oklinov/alu/README.md

View this project on [CADLAB.io](https://cadlab.io/project//TODO). 

# Template for PB170 projects at FI MU Brno
Add your user guide here.

## Photos

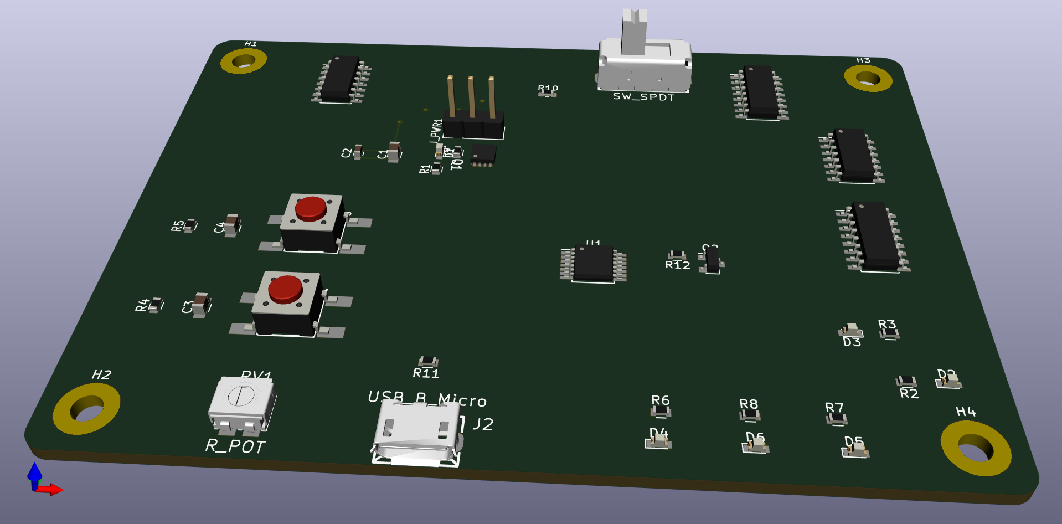
[picture p1: preview/3D.png]
Sample PCB image (unrouted)


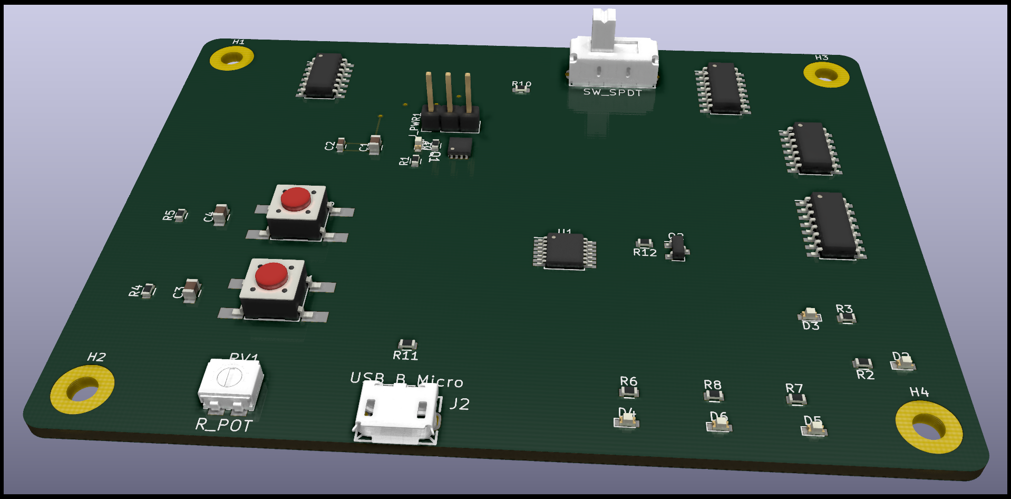
[picture p2: preview/raytracing.png]
Sample PCB image using ray tracing (unrouted)
