oklinov/alu/doc/doc.pdf

# PB170 – ALU

Ondrej Klinovský, Jakub Maloštík

20. februára 2021

Ciel’om tohto projektu bolo vytvorit’ aritmeticko-logickú jednotku (ALU) so štyrmi operáciami. ALU pracuje so 4-bitovými číslami v doplnkovom kóde. Zvo-lili sme dve aritmetické operácie (sčítanie a odčítanie) a dve logické (logický súčin a súčet).

ALU sa ovláda pomocou dvoch tlačítiek a ôsmych prepínačov. Prepínače predstavujú vstup pre dve 4-bitové čísla. Operáciu nad tymíto číslami je možné zvolit’ s dvomi tlačítkami následovne:

X | Y | operácia
0 0 1 1 | 0 1 0 1 | sčítanie odčítanie logický súčin logický súčet

Výstup ALU pozostáva zo štyroch LED-diód predstavujúcich výsledok zvolenej operácie a troch LED-diód predstavujúcich príznaky operácie: nulový výsledok, záporný výsledok a pretečenie aritmetickej operácie.

Celý obvod sme si rozdelili na tri časti: vstup, výstup a samotná ALU. Výstup je najjednoduchšia čast’, tvorí ho sedem LED-diód reprezentujúcich 4-bitový výsledok a tri príznaky. Výstup je o niečo zložitejší. Nachádzajú sa tu dve tlačítka napojené na D klopné obvody, vd’aka ktorým sme schopní menit’ operáciu ALU. Osem prepínačov slúži pre zadávanie dvoch 4-bitových čísel pre ALU. Na každý vstup je napojená jedna LED-dióda pre zobrazenie dát, s ktorými ALU pracuje.

Tret’ou, najkomplikovanejšou čast’ou je ALU, ktorá sa pozostáva z aritmetickej (sčítačky) a logickej časti, multiplexeru a logiky pre zobrazenie príznakov. Mut-liplexer na základe významnejšieho bitu operácie rozhoduje, či na vstup pošle výsledok aritmetickej alebo logickej časti. Obe majú na vstupe dve 4-bitové čísla a operačný bit (menej významný bit operácie) a na výstupe 4-bitový výsledok. V logickej časti sa nachádzajú štyri AND brány a štyri OR brány smerujúce do multiplexeru, ktorý na základe operačného bitu rozhodne, ktorý výsledok pošle na výstup. V aritmetickej časti nie je multiplexer potrebný. Odčítanie je možné

1


Obr. 1: Prvotný návrh sme spravili v simulátore digitalnych obvodov Digital. Na obázku je vidiet’ celá shéma obvodu ALU. Pre zjednodušenie návrhu sme použili vstavané komponenty ako sčítačky alebo multiplexer. Vstupy su riešené jednoduchými prepínačmi.

previest’ inverziou bitov čísla B a pripočítanie jednotky k výsledku. Inverzia bitov je implementovaná pomocou XOR brány. Zatial’ čo číslo A na napojené priamo na sčítačku, číslo B prechádza cez XOR brány, kde tvorí vstup spolu s operačným bitom. Ak je operačný bit 0 (sčítanie), číslo B prejde XORmi bez zmeny. V prípade odčítania (operačný bit má hodnotu 1) XOR invertuje všetky bity čísla B. Pripočítanie jednotky je docielené tým, že operačný bit je napojený na carry-in vstup sčítačky. V prípade sčitovania bude mat’ carry-in hodnotu
0. Okrem 4-bitového čísla ma sčítačka na výstupe bit signalizujúci pretečenie, ktorý je výsledkom XOR operácie dvoch najvýznamnejších bitov výsledného čísla.

2

# LED red+5V GND R⁴³ 220R

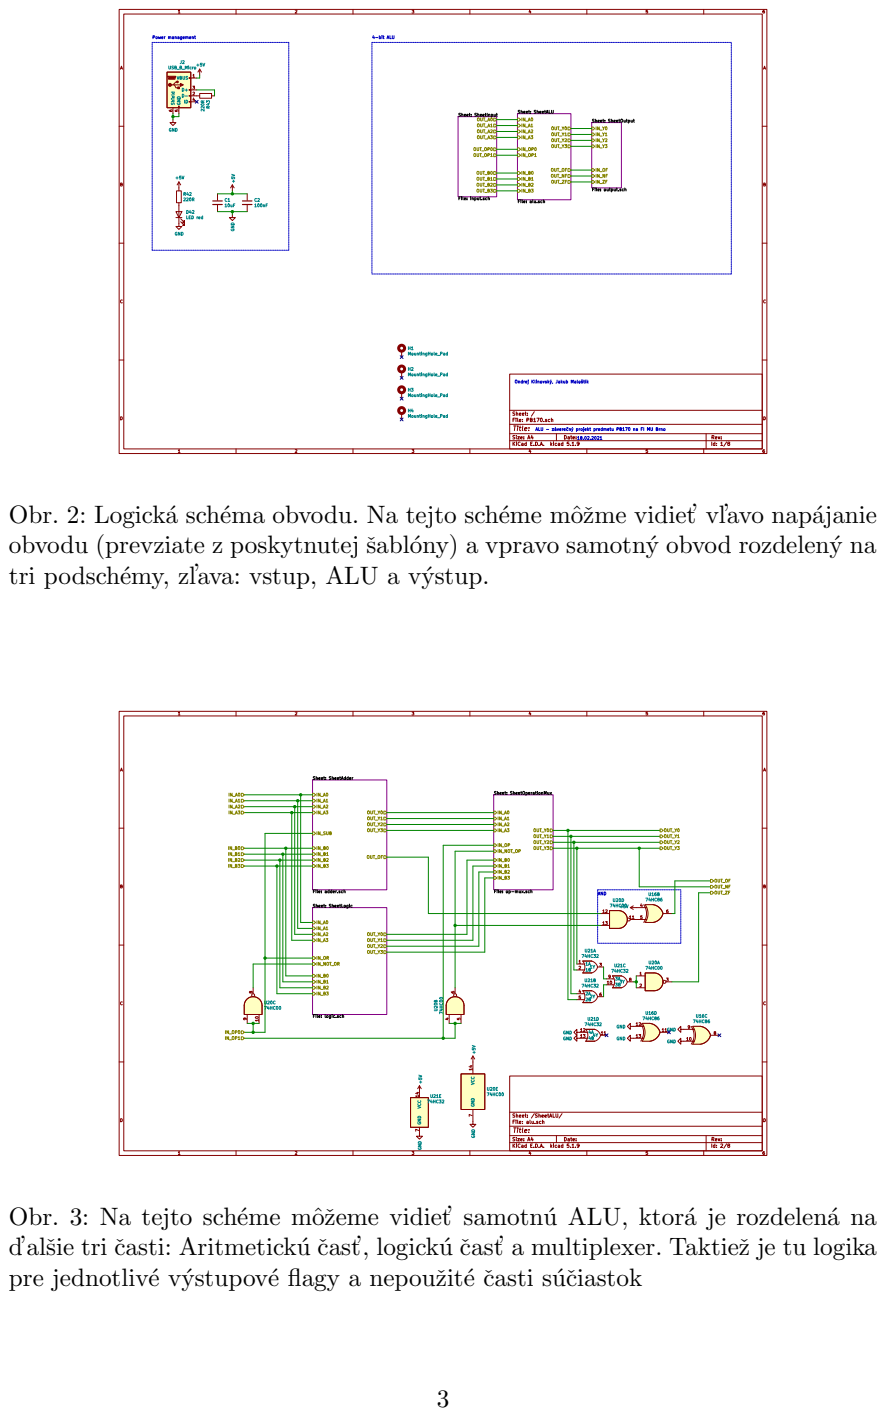
[picture p5: page 3]

Id: 1/8 Title: File: PB170.sch Sheet: / Sheet: SheetInput

Ondrej Klinovský, Jakub Malotík

18.02.2021 ALU - záverený projekt predmetu PB170 na FI MU Brno

Obr. 2: Logická schéma obvodu. Na tejto schéme môžme vidiet’ vl’avo napájanie
obvodu (prevziate z poskytnutej šablóny) a vpravo samotný obvod rozdelený na

Sheet: SheetAdder File: adder.sch

Id: 2/8 Title: File: alu.sch Sheet: /SheetALU/ Sheet: SheetOperationMux

File: op-mux.sch

Obr. 3: Na tejto schéme môžeme vidiet’ samotnú ALU, ktorá je rozdelená na
d’alšie tri časti: Aritmetickú čast’, logickú čast’ a multiplexer. Taktiež je tu logika
pre jednotlivé výstupové flagy a nepoužité časti súčiastok

# 74HC74 D8

## 3 SW2 SW_SPDT D10

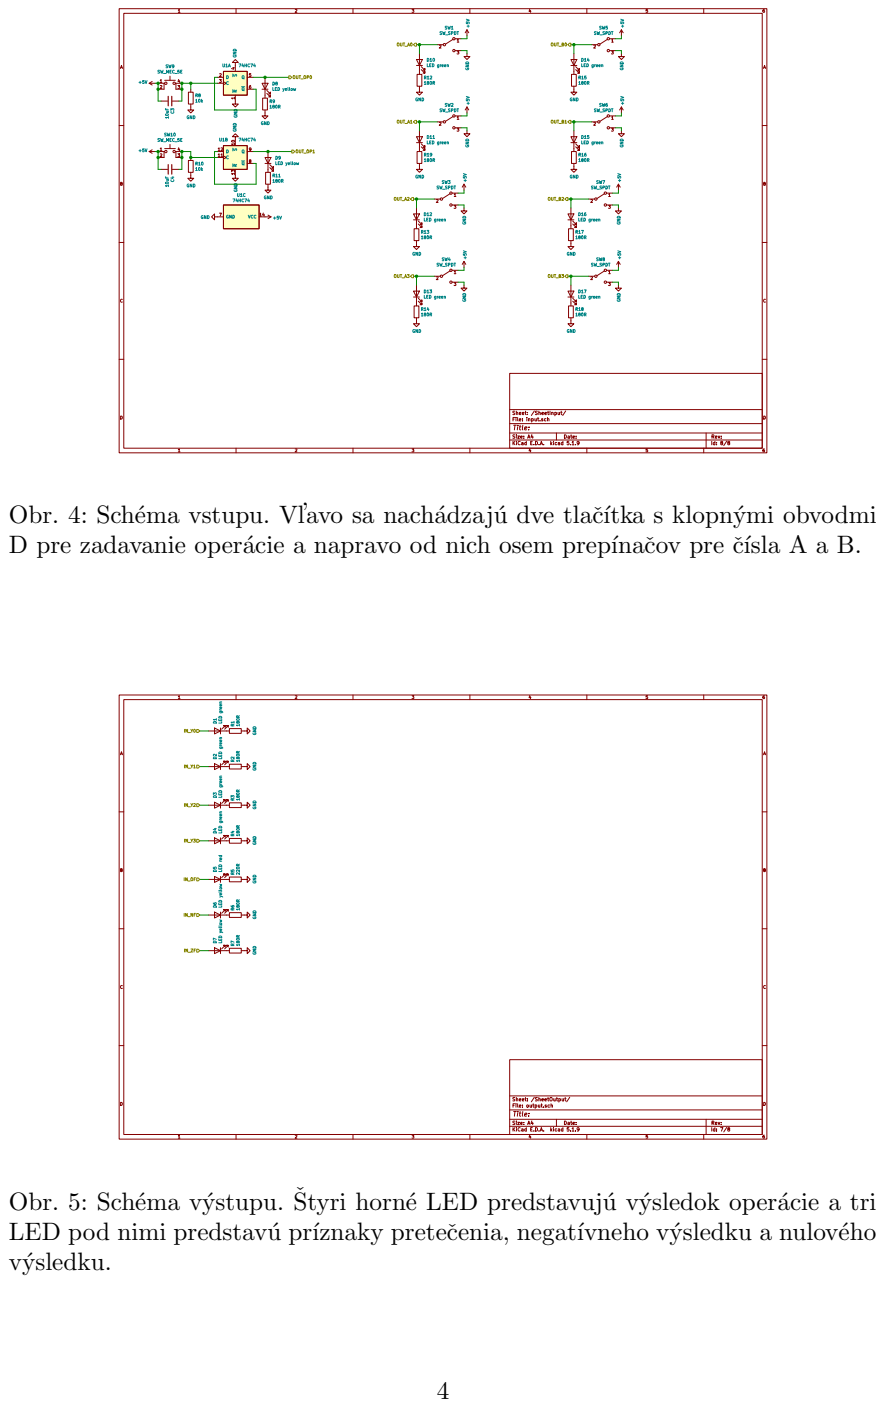
[picture p6: page 4]

Obr. 4: Schéma vstupu. Vl’avo sa nachádzajú dve tlačítka s klopnými obvodmi

Obr. 5: Schéma výstupu. Styri horné LED predstavujú výsledok operácie a tri ˇ
LED pod nimi predstavú príznaky pretečenia, negatívneho výsledku a nulového
výsledku.

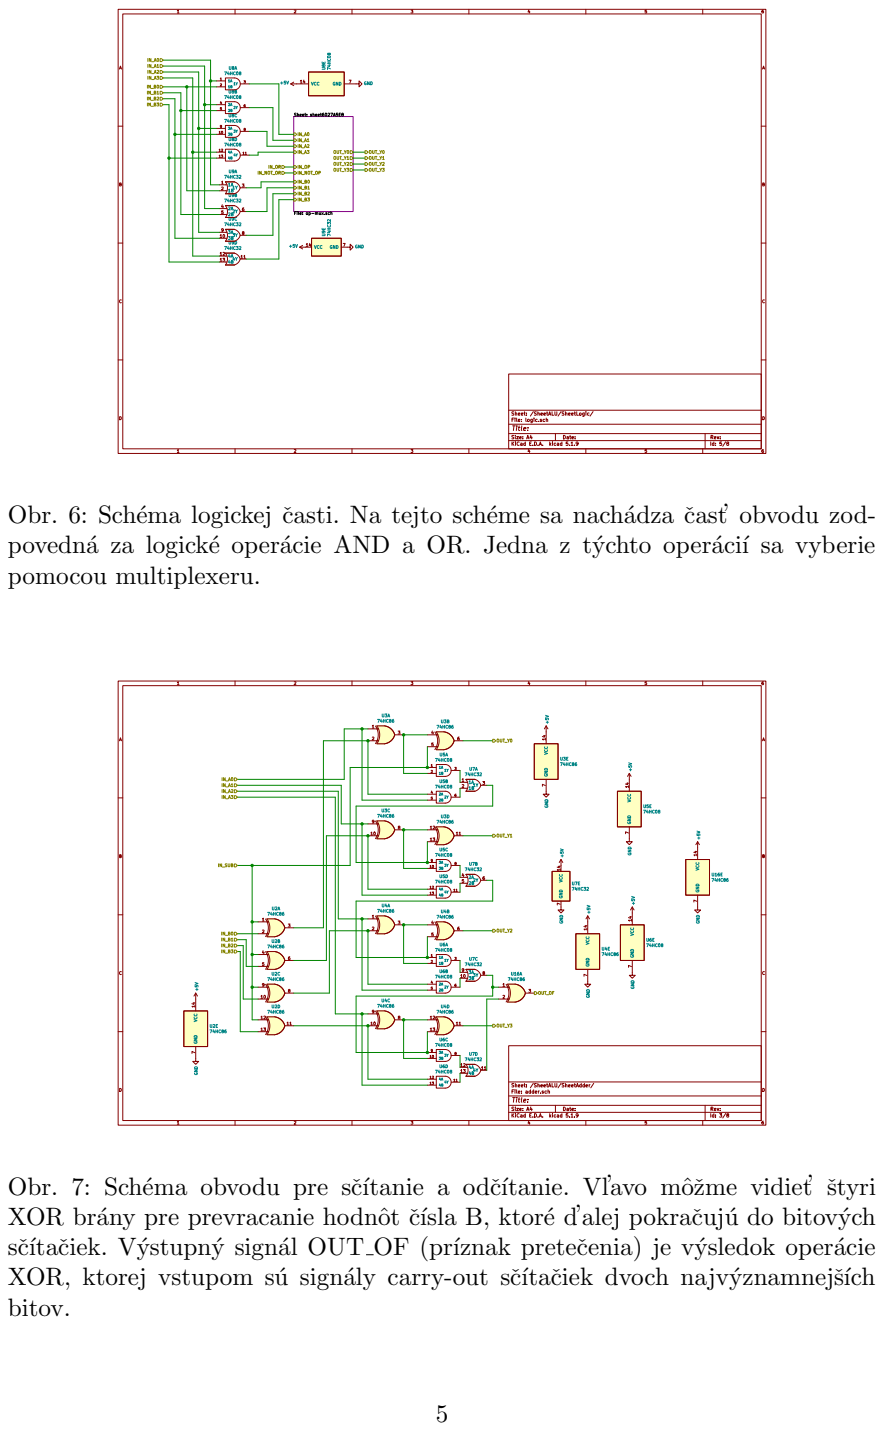
[picture p7: page 5]

Sheet: /SheetALU/SheetLogic/ Sheet: sheet6027A5E8 File: op-mux.sch

Obr. 6: Schéma logickej časti. Na tejto schéme sa nachádza čast’ obvodu zod-
povedná za logické operácie AND a OR. Jedna z týchto operácií sa vyberie

Obr. 7: Schéma obvodu pre sčítanie a odčítanie. Vl’avo môžme vidiet’ štyri
XOR brány pre prevracanie hodnôt čísla B, ktoré d’alej pokračujú do bitových
sčítačiek. Výstupný signál OUT OF (príznak pretečenia) je výsledok operácie
XOR, ktorej vstupom sú signály carry-out sčítačiek dvoch najvýznamnejších
bitov.

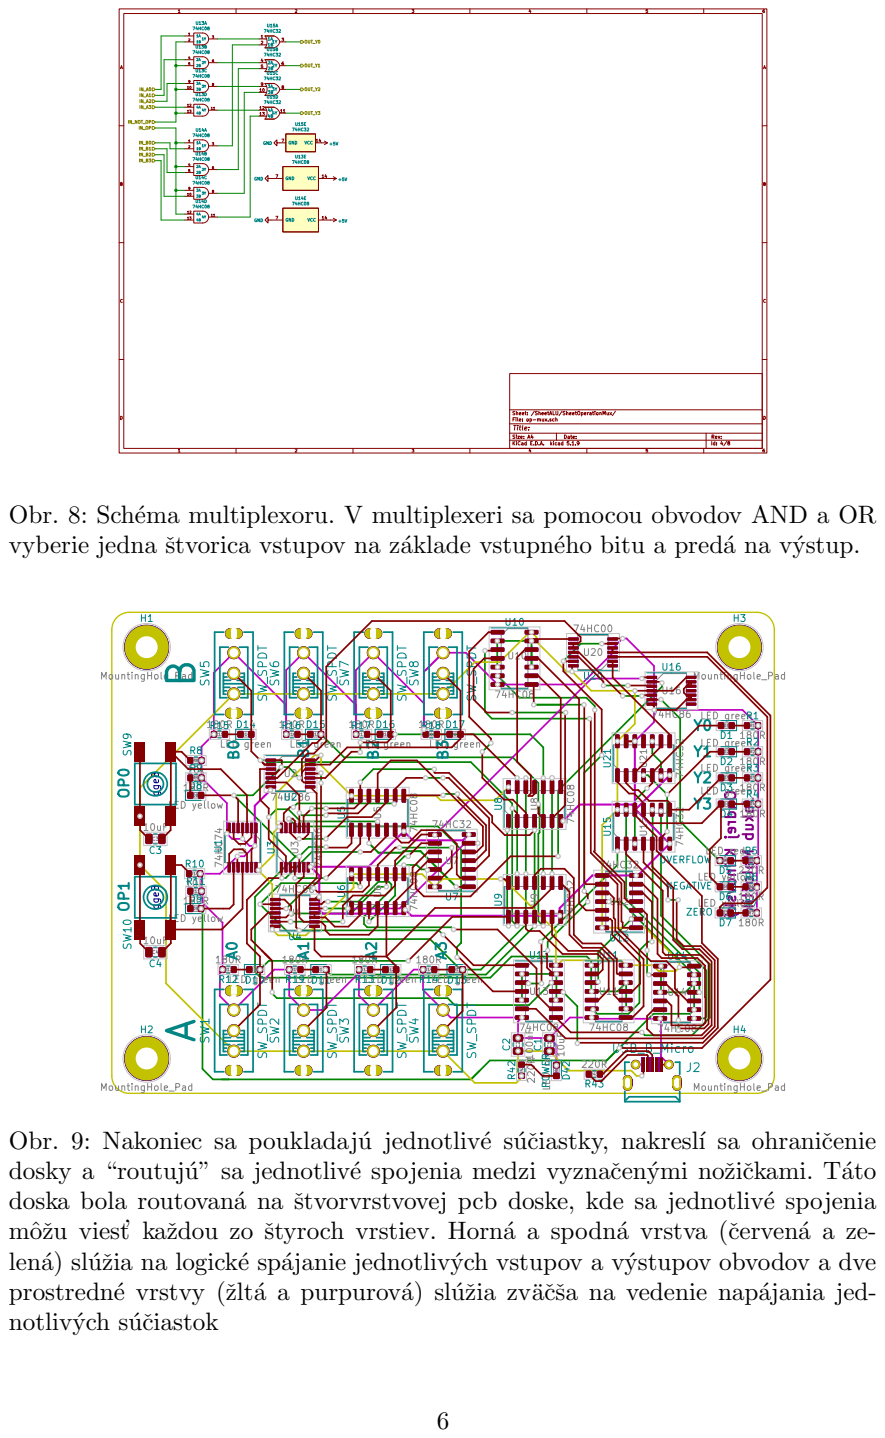
[picture p8: page 6]

Sheet: /SheetALU/SheetOperationMux/ GND

File: op-mux.sch
Id: 4/8 Title:

Obr. 8: Schéma multiplexoru. V multiplexeri sa pomocou obvodov AND a OR
vyberie jedna štvorica vstupov na základe vstupného bitu a predá na výstup.

Obr. 9: Nakoniec sa poukladajú jednotlivé súčiastky, nakreslí sa ohraničenie
dosky a “routujú” sa jednotlivé spojenia medzi vyznačenými nožičkami. Táto
doska bola routovaná na štvorvrstvovej pcb doske, kde sa jednotlivé spojenia
môžu viest’ každou zo štyroch vrstiev. Horná a spodná vrstva (červená a ze-
lená) slúžia na logické spájanie jednotlivých vstupov a výstupov obvodov a dve
prostredné vrstvy (žltá a purpurová) slúžia zväčša na vedenie napájania jed-
notlivých súčiastok
