oklinov/alu/doc/img/pcb.pdf

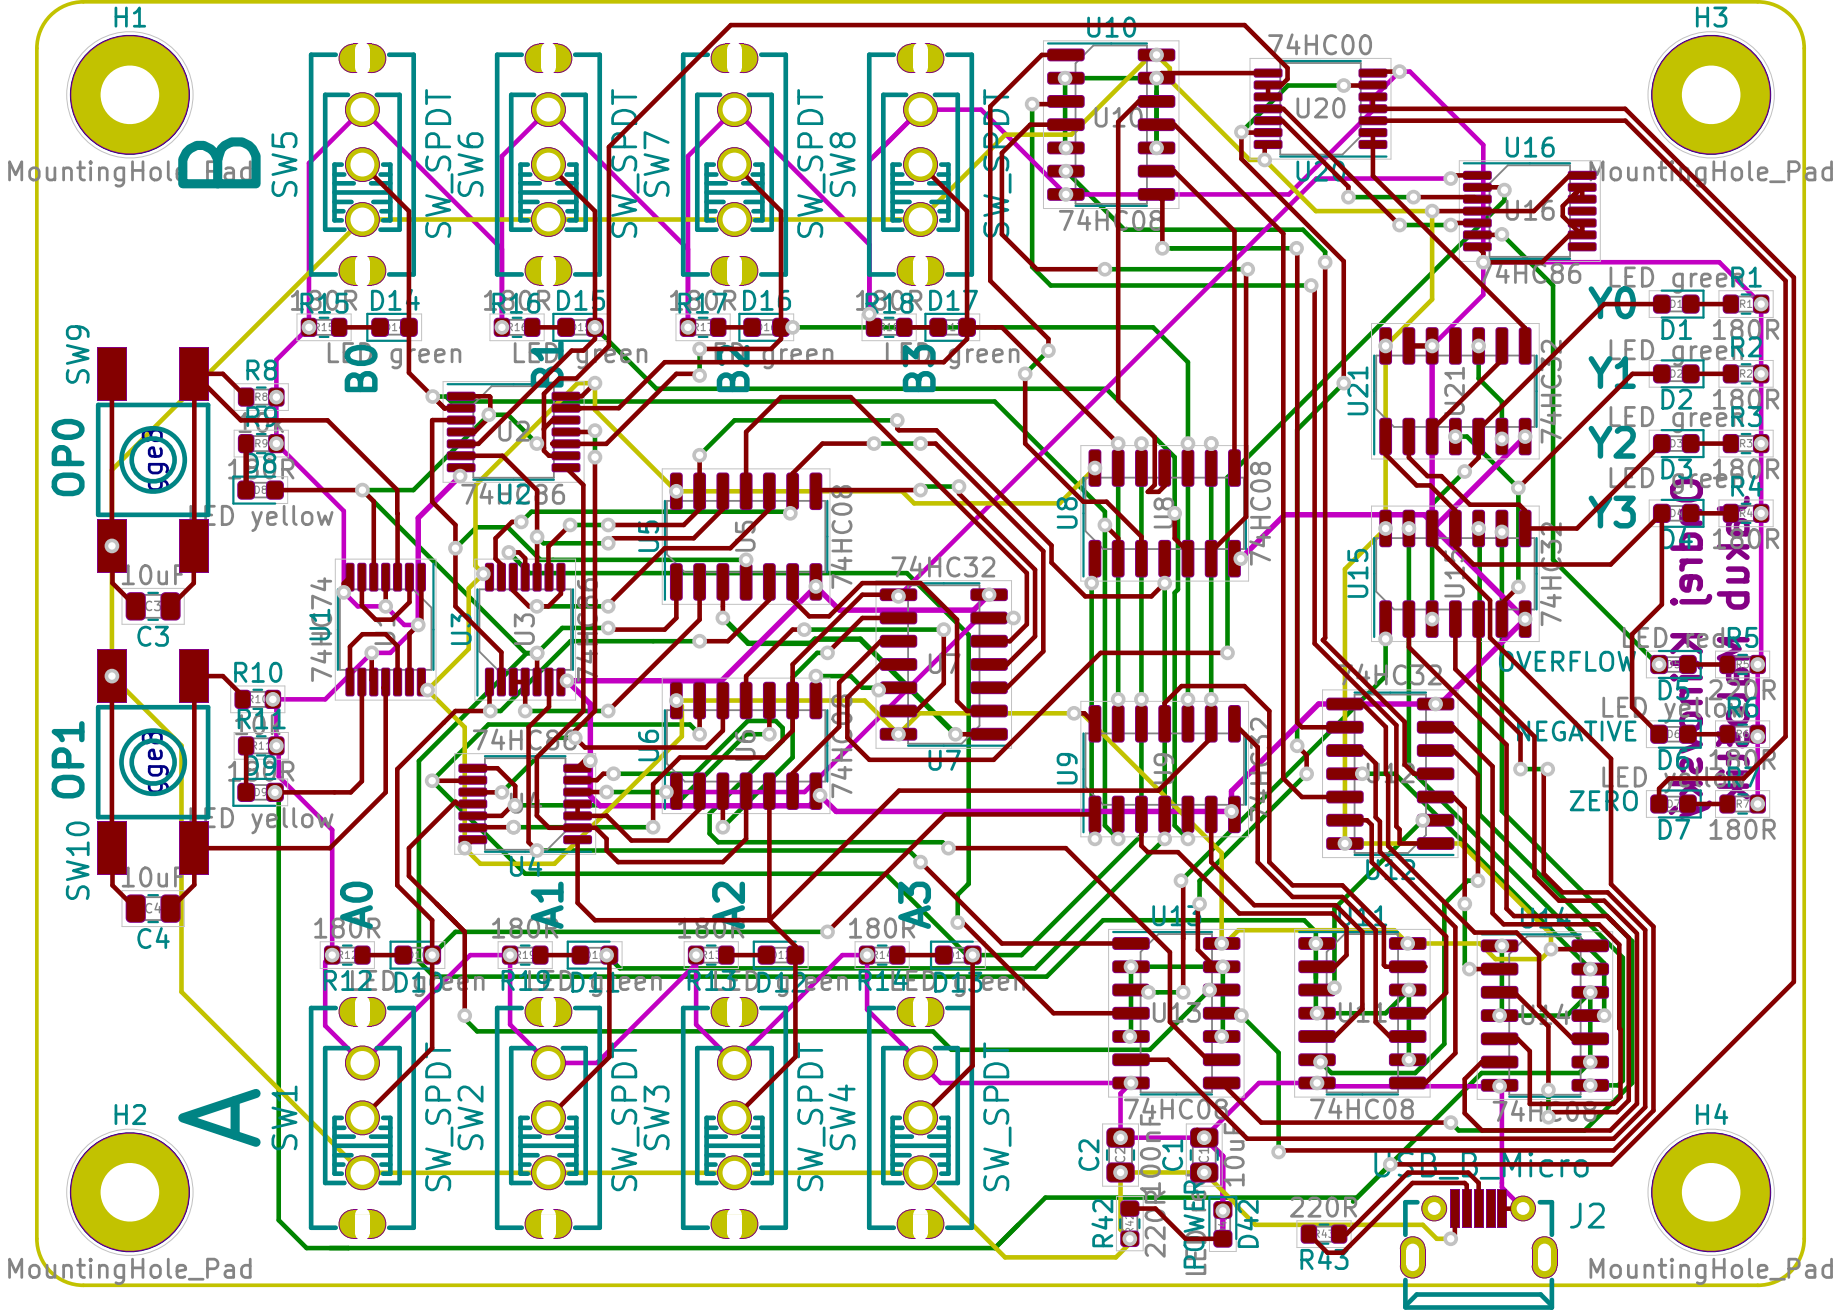
[picture p9: page 1]
