oklinov/alu/doc/img/adder_sheet.pdf

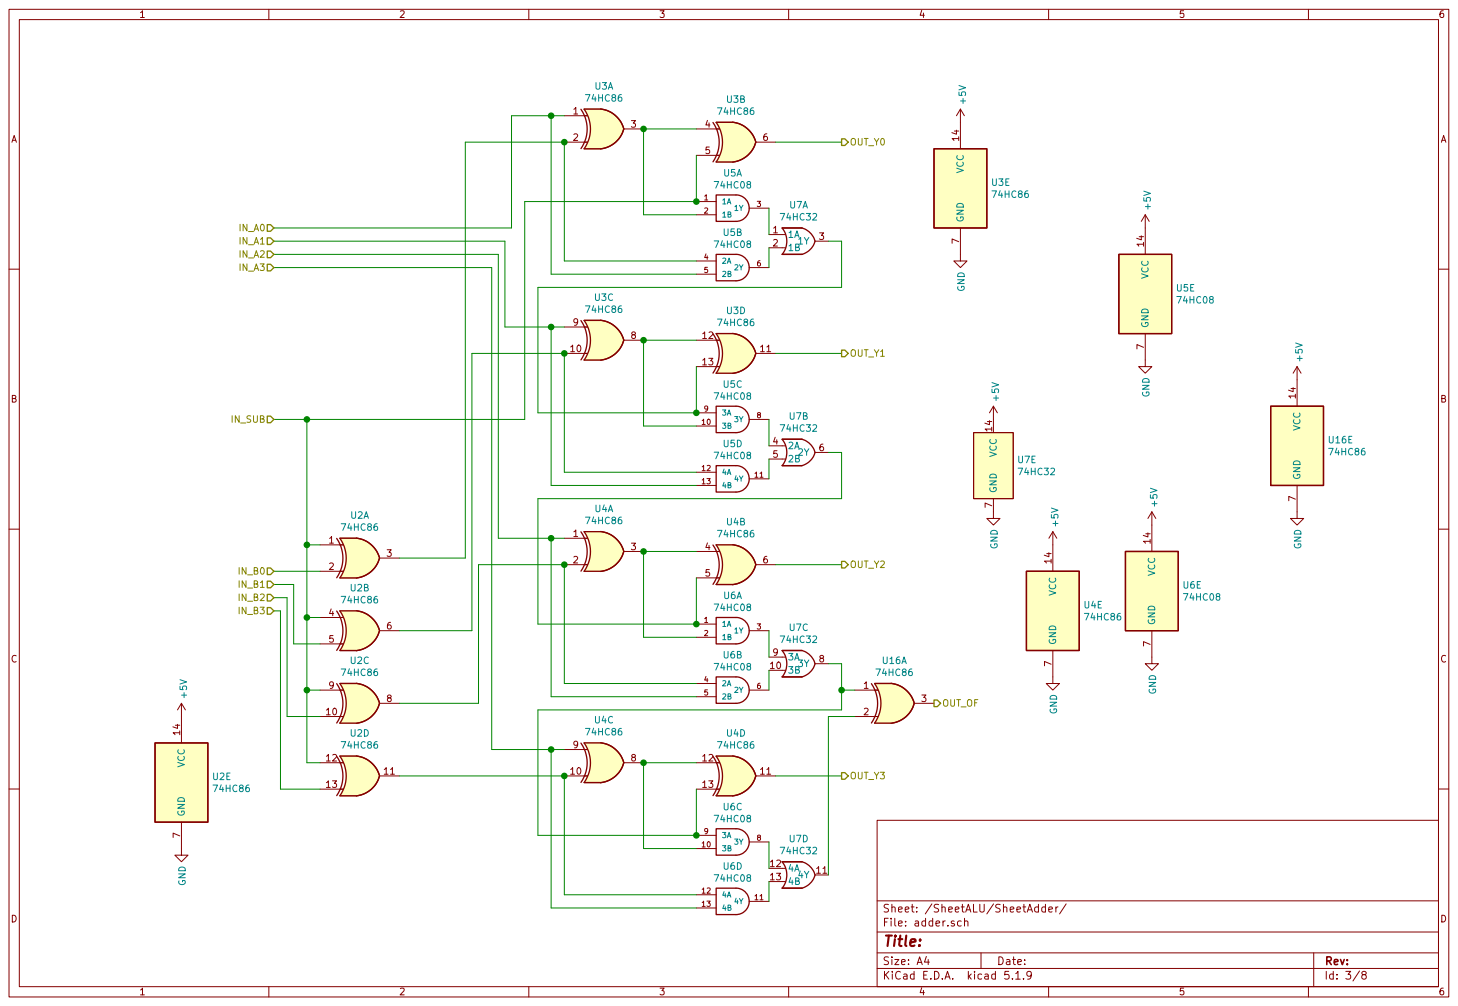
[picture p10: page 1]
