oklinov/alu/doc/img/alu_sheet.pdf

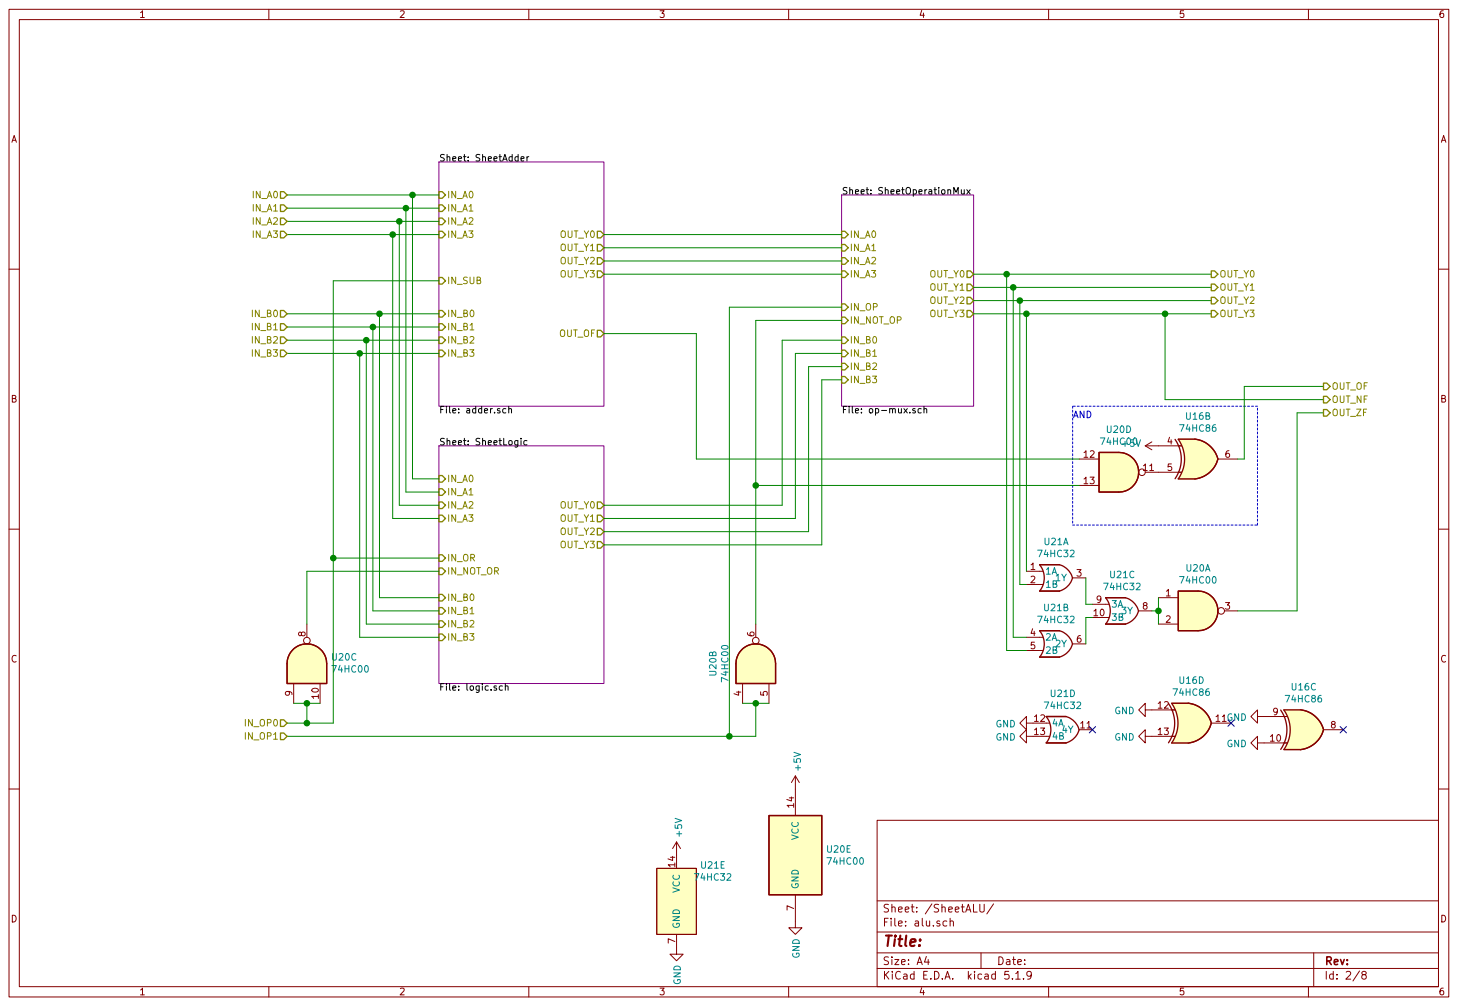
[picture p11: page 1]

Sheet: SheetAdder File: adder.sch

File: op-mux.sch

Id: 2/8 Title: File: alu.sch Sheet: /SheetALU/
