oklinov/alu/doc/img/input_sheet.pdf

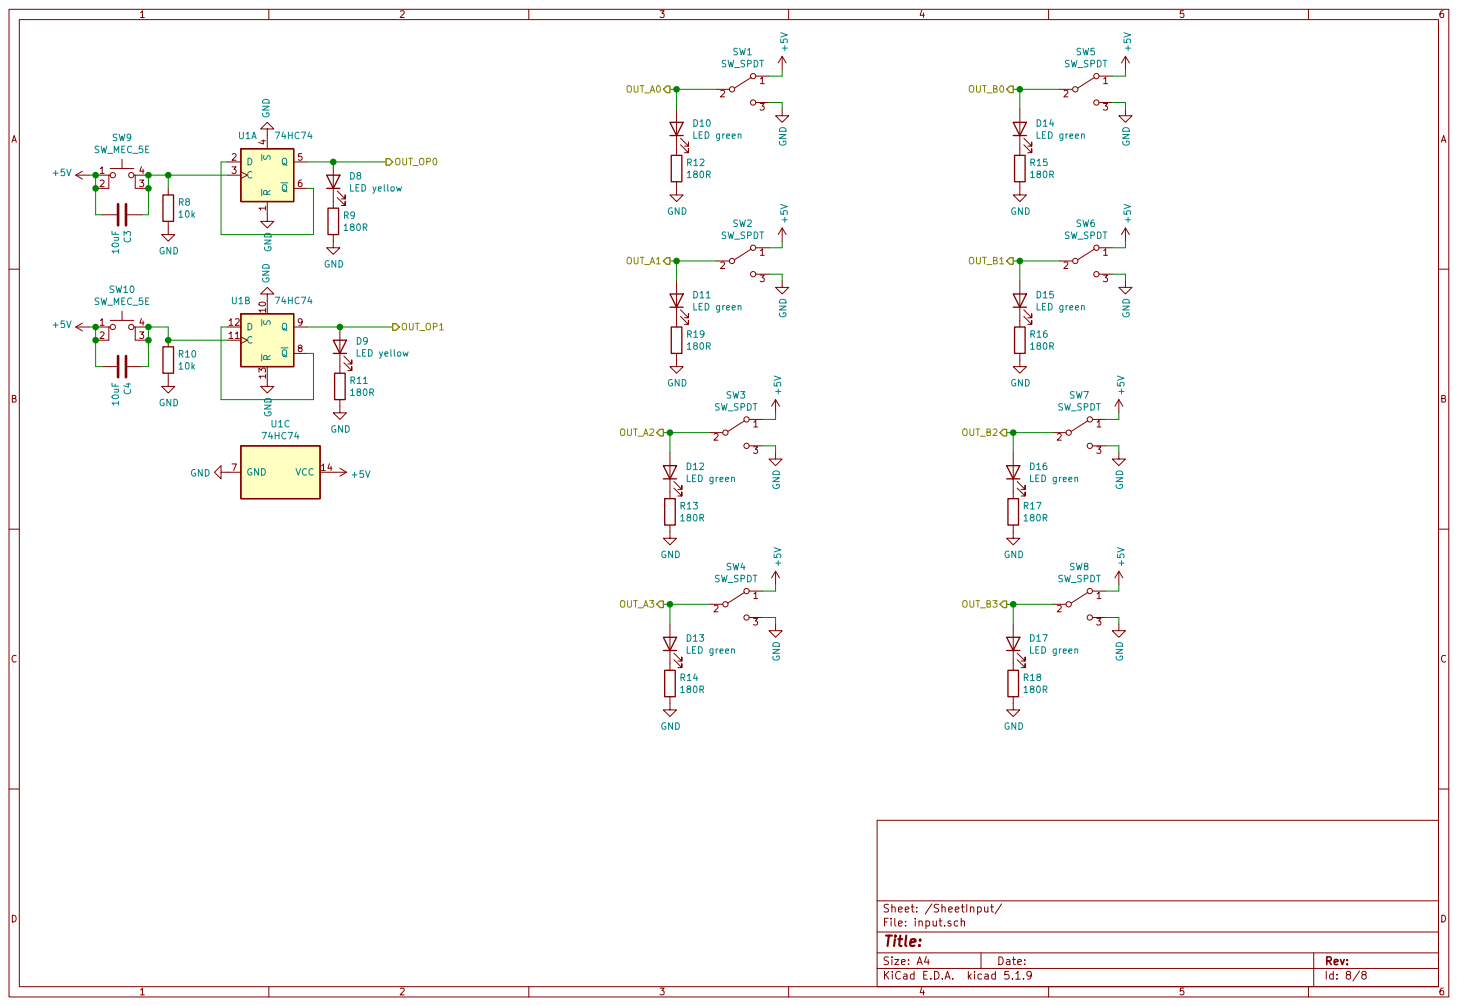
[picture p12: page 1]
