oklinov/alu/doc/img/logic_sheet.pdf

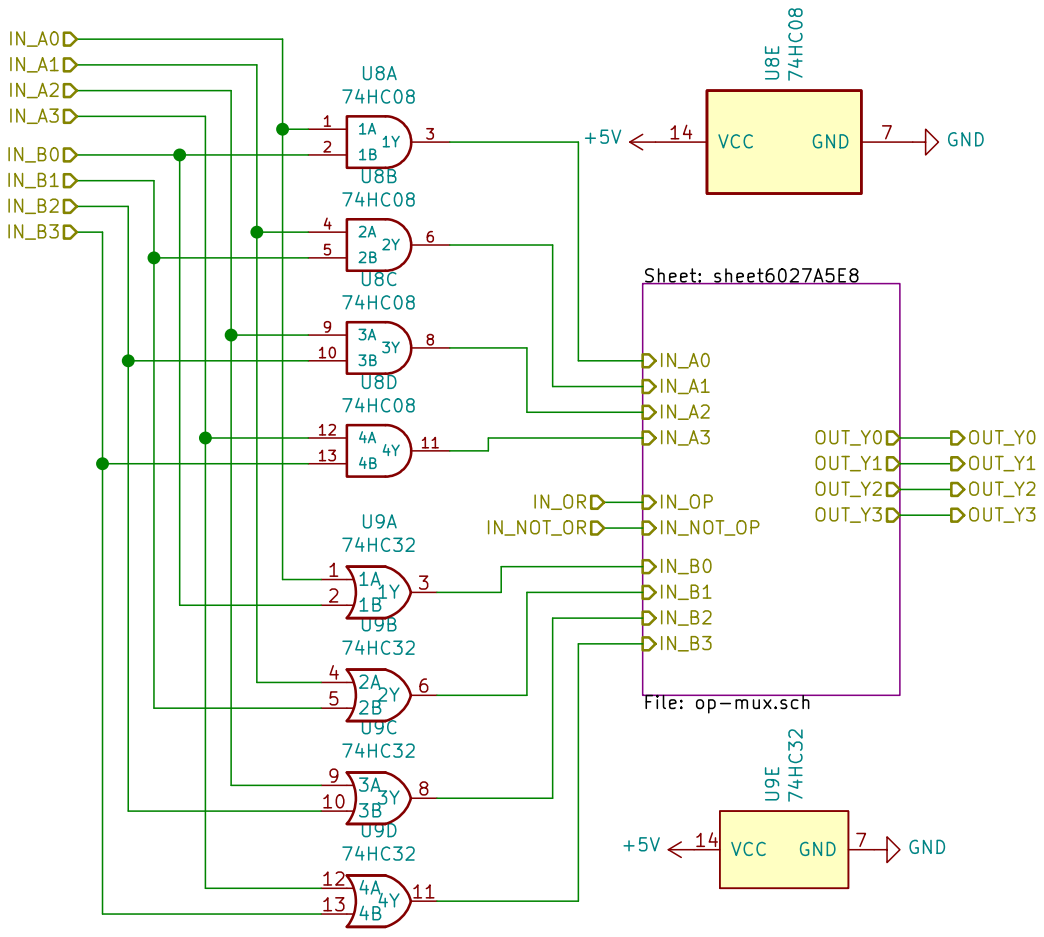
[picture p13: page 1]

Sheet: sheet6027A5E8 File: op-mux.sch
