oklinov/alu/doc/img/mux_sheet.pdf

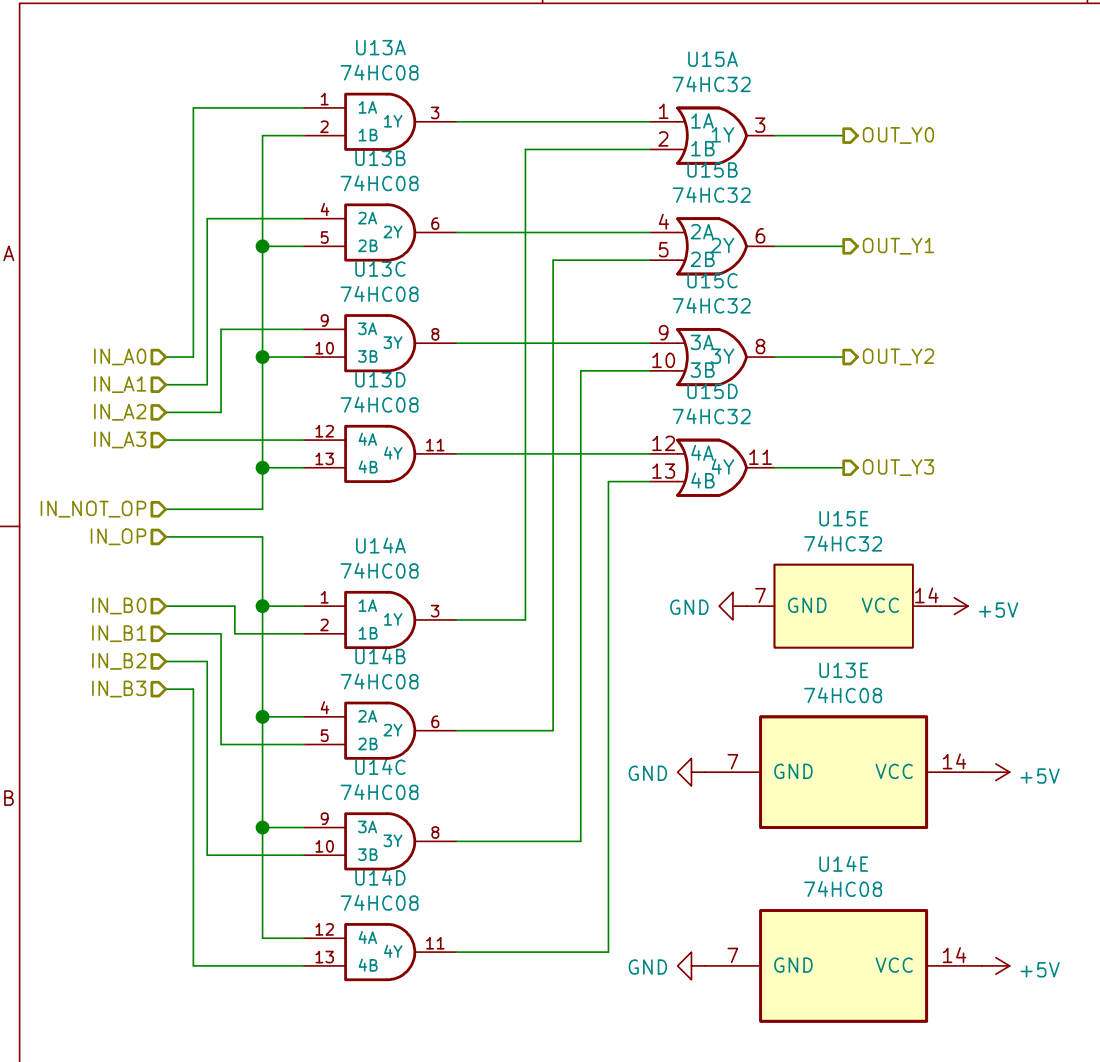
[picture p14: page 1]

Sheet: /SheetALU/SheetOperationMux/
File: op-mux.sch
Id: 4/8 Title:
