oklinov/alu/doc/img/output_sheet.pdf

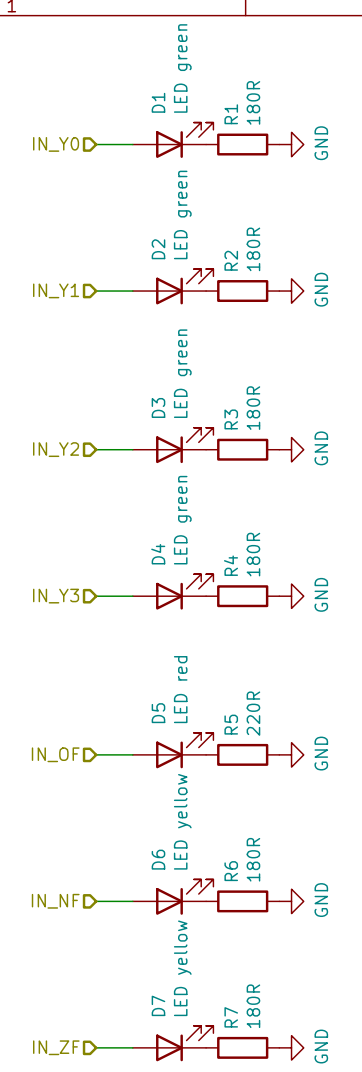
[picture p15: page 1]
