oklinov/alu/doc/img/top_sheet.pdf

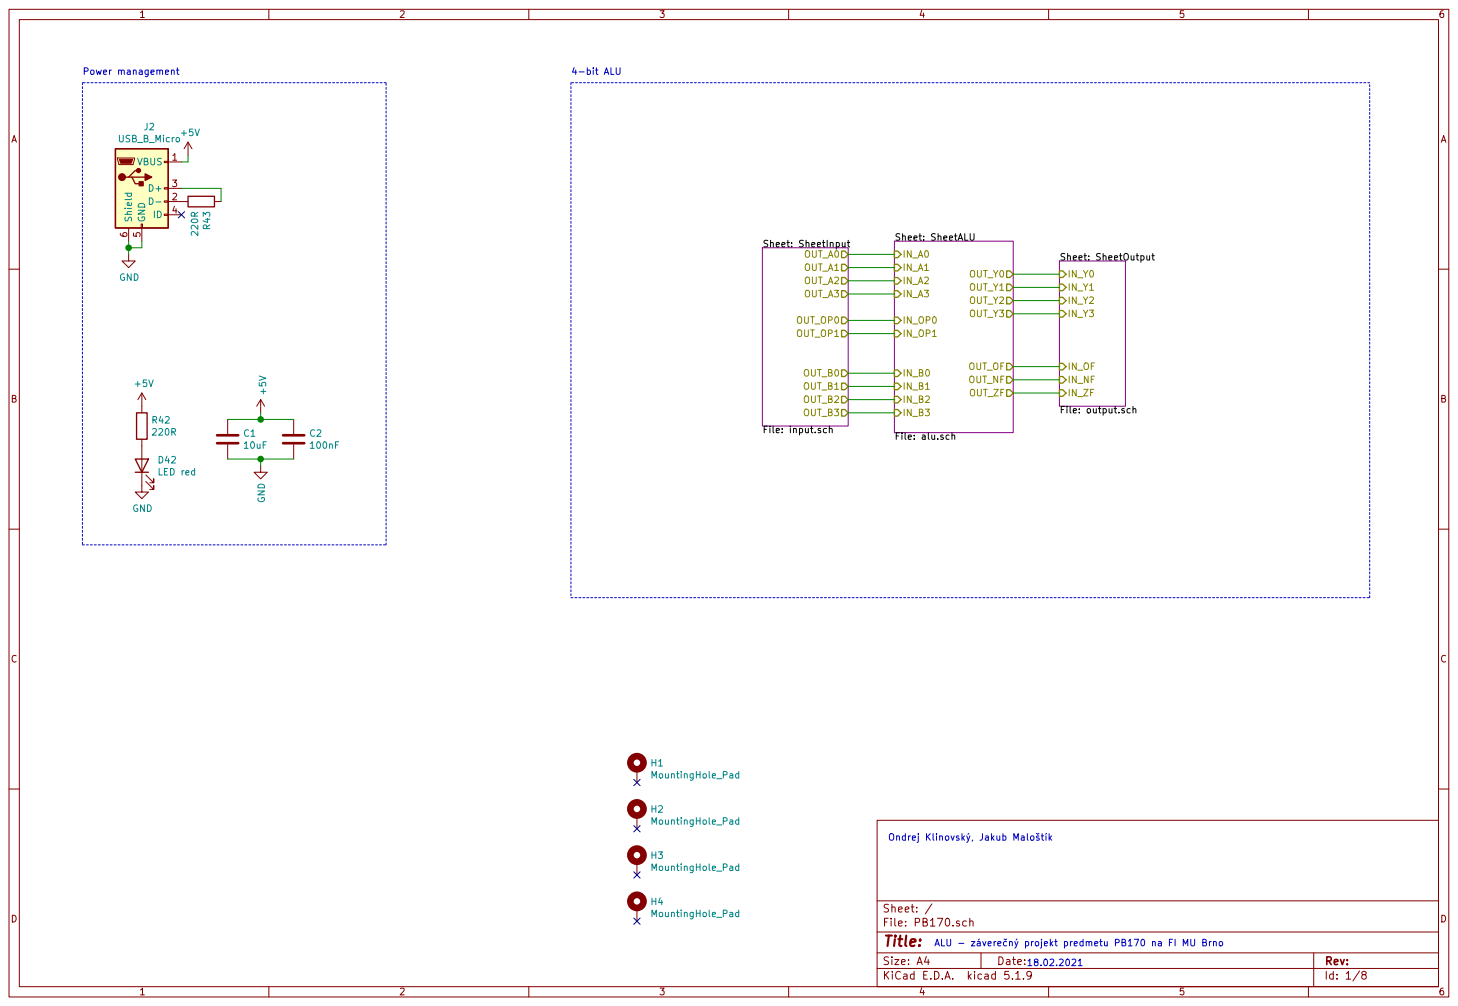
[picture p16: page 1]

Ondrej Klinovský, Jakub Malotík

Id: 1/8 Title: File: PB170.sch Sheet: /

18.02.2021 ALU - záverený projekt predmetu PB170 na FI MU Brno
