oklinov/alu/PB170.kicad_pcb

## KiCad design PB170.kicad_pcb (2021-02-18)

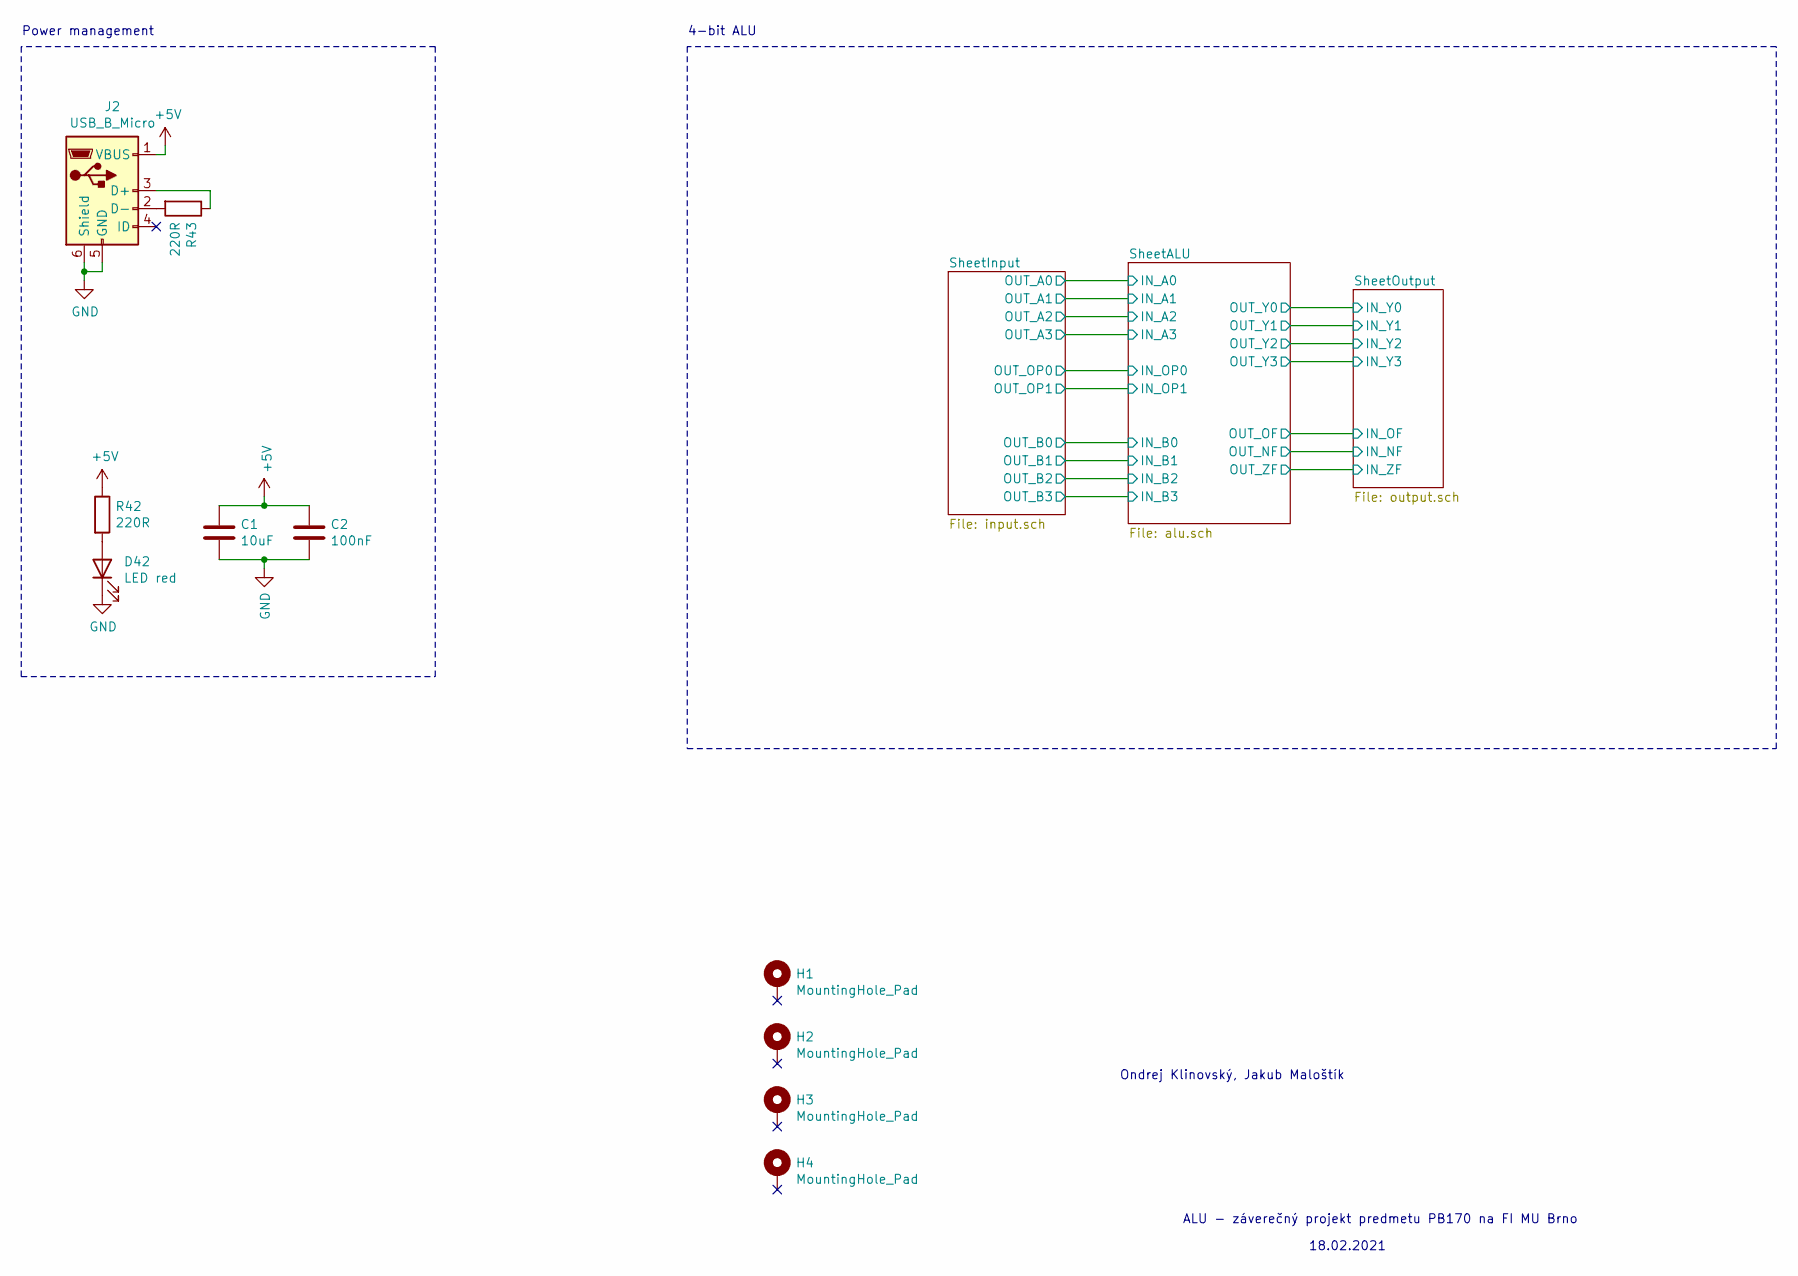
[picture p17: schematic PB170.sch]

Parts:
C1: 10uF; C_0805_2012Metric; LCSC C15850
C2: 100nF; C_0805_2012Metric; LCSC C14663
D42: LED red; LED_0603_1608Metric; LCSC C2286
H1, H2, H3, H4: MountingHole_Pad; MountingHole_3.2mm_M3_Pad
J2: USB_B_Micro; MICRO-USB-SMD_MICROXNJ; LCSC C404969
R42, R43: 220R; R_0603_1608Metric; LCSC C22962

Connections:
+5V: C1.1, C2.1, J2.1 (VBUS), R42.1; also elsewhere on the board
GND: C1.2, C2.2, D42.1 (K), J2.5 (GND), J2.6 (Shield); also elsewhere on the board
unnamed: D42.2 (A), R42.2
unnamed: J2.2 (D-), R43.2
unnamed: J2.3 (D+), R43.1

Notes on the sheet:
ALU - záverečný projekt predmetu PB170 na FI MU Brno
Ondrej Klinovský, Jakub Maloštík
Power management
4-bit ALU
18.02.2021

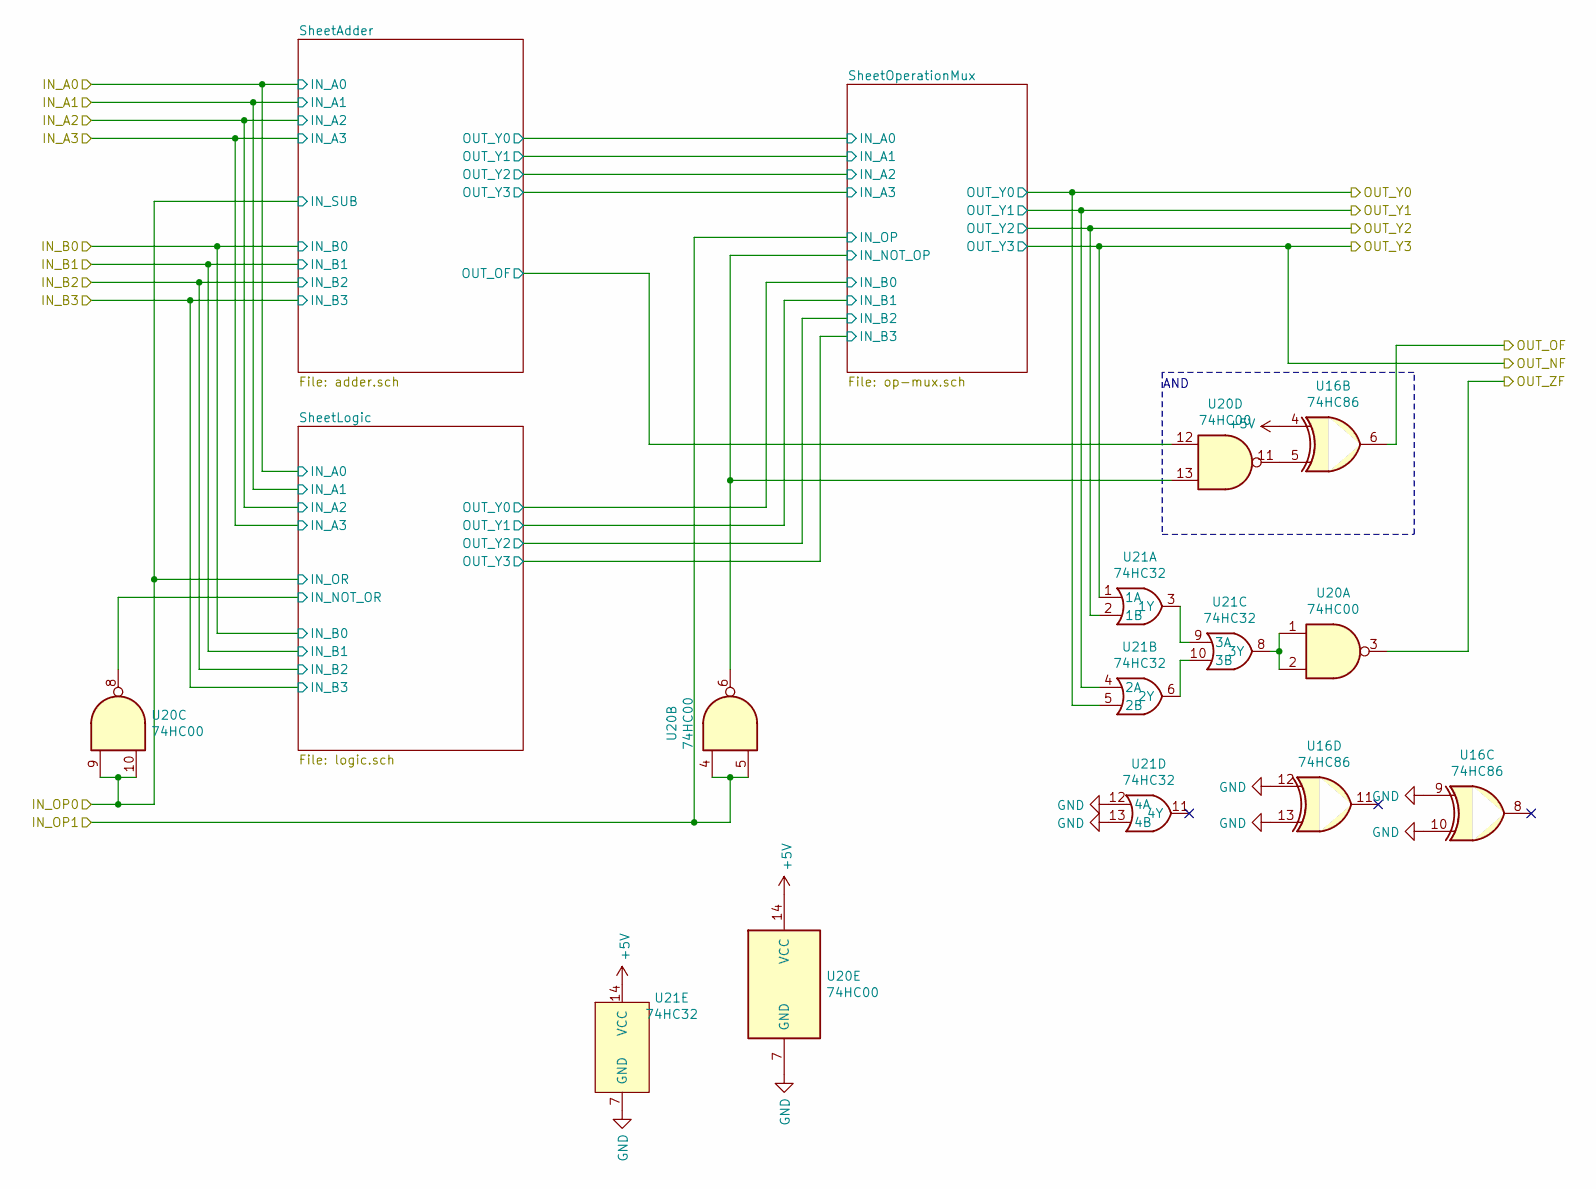
[picture p18: schematic alu.sch]

Parts:
U16: 74HC86; TSSOP-14_4.4x5mm_P0.65mm; LCSC C117522
U20: 74HC00; TSSOP-14_4.4x5mm_P0.65mm; LCSC C6807
U21: 74HC32; SOIC-14_3.9x8.7mm_P1.27mm; LCSC C5632

Connections:
+5V: U16.4, U20.14 (VCC), U21.14 (VCC); also elsewhere on the board
/SheetALU/IN_OP0: U20.9, U20.10; also elsewhere on the board
/SheetALU/IN_OP1: U20.4, U20.5; also elsewhere on the board
/SheetALU/SheetAdder/OUT_OF: U20.12; also elsewhere on the board
/SheetALU/SheetLogic/IN_NOT_OR: U20.8; also elsewhere on the board
/SheetALU/SheetOperationMux/IN_NOT_OP: U20.6, U20.13; also elsewhere on the board
/SheetOutput/IN_NF: U21.1 (1A); also elsewhere on the board
/SheetOutput/IN_OF: U16.6; also elsewhere on the board
/SheetOutput/IN_Y0: U21.5 (2B); also elsewhere on the board
/SheetOutput/IN_Y1: U21.4 (2A); also elsewhere on the board
/SheetOutput/IN_Y2: U21.2 (1B); also elsewhere on the board
/SheetOutput/IN_ZF: U20.3; also elsewhere on the board
GND: U16.9, U16.10, U16.12, U16.13, U20.7 (GND), U21.7 (GND), U21.12 (4A), U21.13 (4B); also elsewhere on the board
unnamed: U16.5, U20.11
unnamed: U20.1, U20.2, U21.8 (3Y)
unnamed: U21.3 (1Y), U21.9 (3A)
unnamed: U21.6 (2Y), U21.10 (3B)

Notes on the sheet:
AND

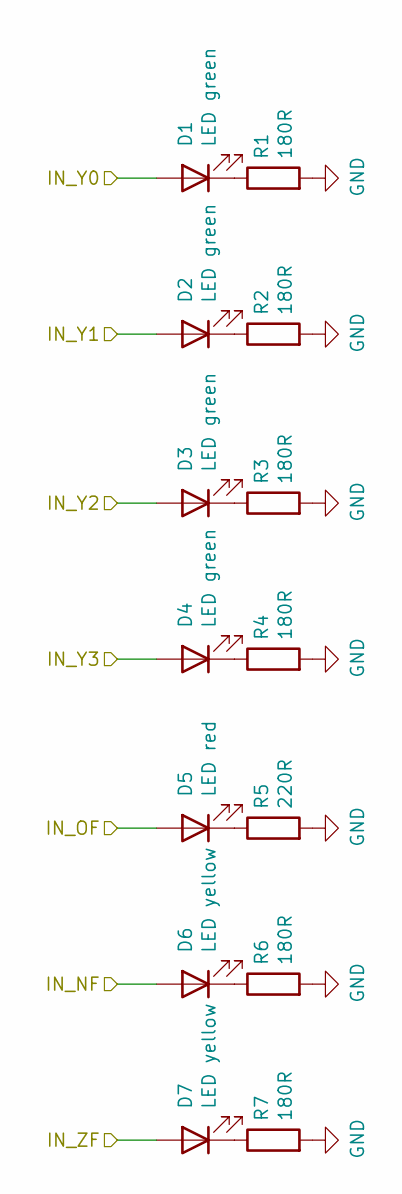
[picture p19: schematic output.sch]

Parts:
D1, D2, D3, D4: LED green; LED_0603_1608Metric; LCSC C72043
D5: LED red; LED_0603_1608Metric; LCSC C2286
D6, D7: LED yellow; LED_0603_1608Metric; LCSC C72038
R1, R2, R3, R4, R6, R7: 180R; R_0603_1608Metric; LCSC C22828
R5: 220R; R_0603_1608Metric; LCSC C22962

Connections:
/SheetOutput/IN_NF: D4.2 (A), D6.2 (A); also elsewhere on the board
/SheetOutput/IN_OF: D5.2 (A); also elsewhere on the board
/SheetOutput/IN_Y0: D1.2 (A); also elsewhere on the board
/SheetOutput/IN_Y1: D2.2 (A); also elsewhere on the board
/SheetOutput/IN_Y2: D3.2 (A); also elsewhere on the board
/SheetOutput/IN_ZF: D7.2 (A); also elsewhere on the board
GND: R1.2, R2.2, R3.2, R4.2, R5.2, R6.2, R7.2; also elsewhere on the board
unnamed: D1.1 (K), R1.1
unnamed: D2.1 (K), R2.1
unnamed: D3.1 (K), R3.1
unnamed: D4.1 (K), R4.1
unnamed: D5.1 (K), R5.1
unnamed: D6.1 (K), R6.1
unnamed: D7.1 (K), R7.1

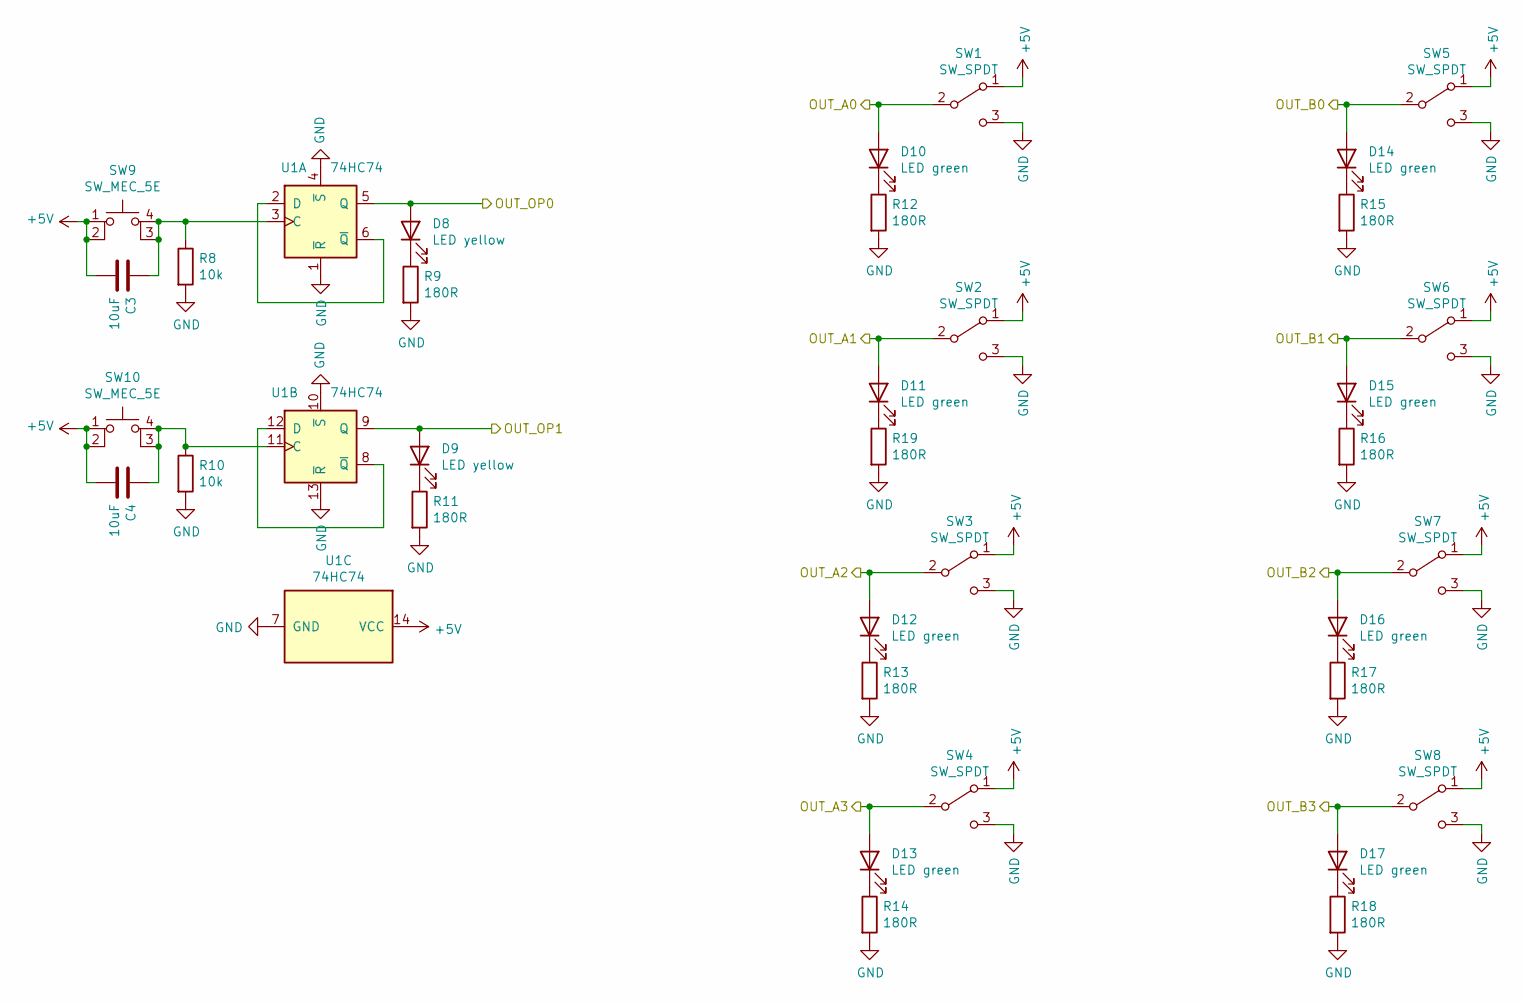
[picture p20: schematic input.sch]

Parts:
C3, C4: 10uF; C_0805_2012Metric; LCSC C15850
D8, D9: LED yellow; LED_0603_1608Metric; LCSC C72038
D10, D11, D12, D13, D14, D15, D16, D17: LED green; LED_0603_1608Metric; LCSC C72043
R8, R10: 10k; R_0603_1608Metric; LCSC C25804
R9, R11, R12, R13, R14, R15, R16, R17, R18, R19: 180R; R_0603_1608Metric; LCSC C22828
SW1, SW2, SW3, SW4, SW5, SW6, SW7, SW8: SW_SPDT; toggleSwitch; LCSC C136718
SW9, SW10: SW_MEC_5E; TactileSwitch_C381064; LCSC C381064
U1: 74HC74; TSSOP-14_4.4x5mm_P0.65mm; LCSC C6761

Connections:
+5V: C3.2, C4.2, SW1.1 (A), SW2.1 (A), SW3.1 (A), SW4.1 (A), SW5.1 (A), SW6.1 (A), SW7.1 (A), SW8.1 (A), SW9.1, SW9.2, SW10.1, SW10.2, U1.14 (VCC); also elsewhere on the board
/SheetALU/IN_A0: D10.2 (A), SW1.2 (B); also elsewhere on the board
/SheetALU/IN_A1: D11.2 (A), SW2.2 (B); also elsewhere on the board
/SheetALU/IN_A2: D12.2 (A), SW3.2 (B); also elsewhere on the board
/SheetALU/IN_A3: D13.2 (A), SW4.2 (B); also elsewhere on the board
/SheetALU/IN_B0: D14.2 (A), SW5.2 (B); also elsewhere on the board
/SheetALU/IN_B1: D15.2 (A), SW6.2 (B); also elsewhere on the board
/SheetALU/IN_B2: D16.2 (A), SW7.2 (B); also elsewhere on the board
/SheetALU/IN_B3: D17.2 (A), SW8.2 (B); also elsewhere on the board
/SheetALU/IN_OP0: D8.2 (A), U1.5 (Q); also elsewhere on the board
/SheetALU/IN_OP1: D9.2 (A), U1.9 (Q); also elsewhere on the board
GND: R8.2, R9.2, R10.2, R11.2, R12.2, R13.2, R14.2, R15.2, R16.2, R17.2, R18.2, R19.2, SW1.3 (C), SW2.3 (C), SW3.3 (C), SW4.3 (C), SW5.3 (C), SW6.3 (C), SW7.3 (C), SW8.3 (C), U1.1 (~R), U1.4 (~S), U1.7 (GND), U1.10 (~S), U1.13 (~R); also elsewhere on the board
unnamed: C3.1, R8.1, SW9.3 (K), SW9.4 (A), U1.3 (C)
unnamed: C4.1, R10.1, SW10.3 (K), SW10.4 (A), U1.11 (C)
unnamed: D8.1 (K), R9.1
unnamed: D9.1 (K), R11.1
unnamed: D10.1 (K), R12.1
unnamed: D11.1 (K), R19.1
unnamed: D12.1 (K), R13.1
unnamed: D13.1 (K), R14.1
unnamed: D14.1 (K), R15.1
unnamed: D15.1 (K), R16.1
unnamed: D16.1 (K), R17.1
unnamed: D17.1 (K), R18.1
unnamed: U1.2 (D), U1.6 (~Q)
unnamed: U1.8 (~Q), U1.12 (D)

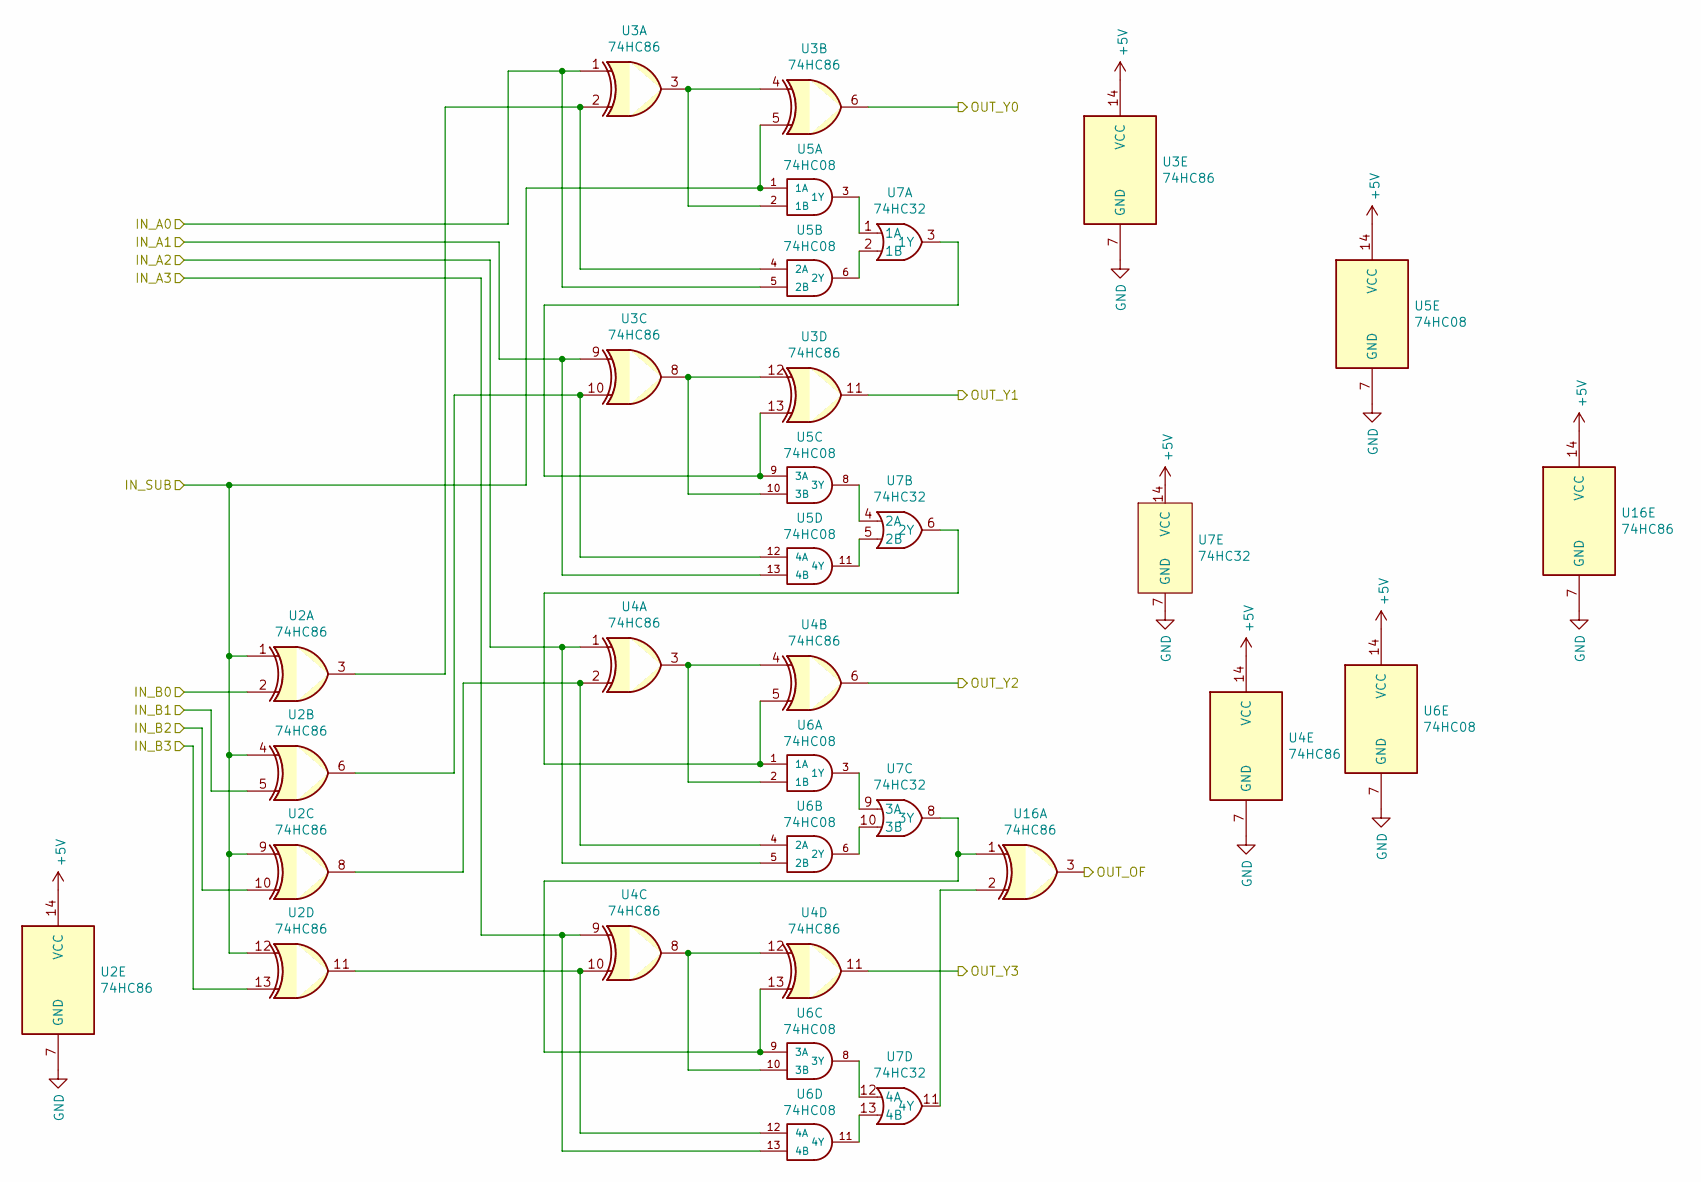
[picture p21: schematic adder.sch]

Parts:
U2, U3, U4, U16: 74HC86; TSSOP-14_4.4x5mm_P0.65mm; LCSC C117522
U5, U6: 74HC08; SOIC-14_3.9x8.7mm_P1.27mm; LCSC C5593
U7: 74HC32; SOIC-14_3.9x8.7mm_P1.27mm; LCSC C5632

Connections:
+5V: U2.14 (VCC), U3.14 (VCC), U4.14 (VCC), U5.14 (VCC), U6.14 (VCC), U7.14 (VCC), U16.14 (VCC); also elsewhere on the board
/SheetALU/IN_A0: U3.1, U5.5 (2B); also elsewhere on the board
/SheetALU/IN_A1: U3.9, U5.13 (4B); also elsewhere on the board
/SheetALU/IN_A2: U4.1, U6.5 (2B); also elsewhere on the board
/SheetALU/IN_A3: U4.9, U6.13 (4B); also elsewhere on the board
/SheetALU/IN_B0: U2.2; also elsewhere on the board
/SheetALU/IN_B1: U2.5; also elsewhere on the board
/SheetALU/IN_B2: U2.10; also elsewhere on the board
/SheetALU/IN_B3: U2.13; also elsewhere on the board
/SheetALU/IN_OP0: U2.1, U2.4, U2.9, U2.12, U3.5, U5.1 (1A); also elsewhere on the board
/SheetALU/SheetAdder/OUT_OF: U16.3; also elsewhere on the board
/SheetALU/SheetOperationMux/IN_A0: U3.6; also elsewhere on the board
/SheetALU/SheetOperationMux/IN_A1: U3.11; also elsewhere on the board
/SheetALU/SheetOperationMux/IN_A2: U4.6; also elsewhere on the board
/SheetALU/SheetOperationMux/IN_A3: U4.11; also elsewhere on the board
GND: U2.7 (GND), U3.7 (GND), U4.7 (GND), U5.7 (GND), U6.7 (GND), U7.7 (GND), U16.7 (GND); also elsewhere on the board
unnamed: U2.3, U3.2, U5.4 (2A)
unnamed: U2.6, U3.10, U5.12 (4A)
unnamed: U2.8, U4.2, U6.4 (2A)
unnamed: U2.11, U4.10, U6.12 (4A)
unnamed: U3.3, U3.4, U5.2 (1B)
unnamed: U3.8, U3.12, U5.10 (3B)
unnamed: U3.13, U5.9 (3A), U7.3 (1Y)
unnamed: U4.3, U4.4, U6.2 (1B)
unnamed: U4.5, U6.1 (1A), U7.6 (2Y)
unnamed: U4.8, U4.12, U6.10 (3B)
unnamed: U5.3 (1Y), U7.1 (1A)
unnamed: U5.6 (2Y), U7.2 (1B)
unnamed: U5.8 (3Y), U7.4 (2A)
unnamed: U5.11 (4Y), U7.5 (2B)
unnamed: U6.3 (1Y), U7.9 (3A)
unnamed: U6.6 (2Y), U7.10 (3B)
unnamed: U6.8 (3Y), U7.12 (4A)
unnamed: U6.11 (4Y), U7.13 (4B)
unnamed: U4.13, U6.9 (3A), U7.8 (3Y), U16.1
unnamed: U7.11 (4Y), U16.2

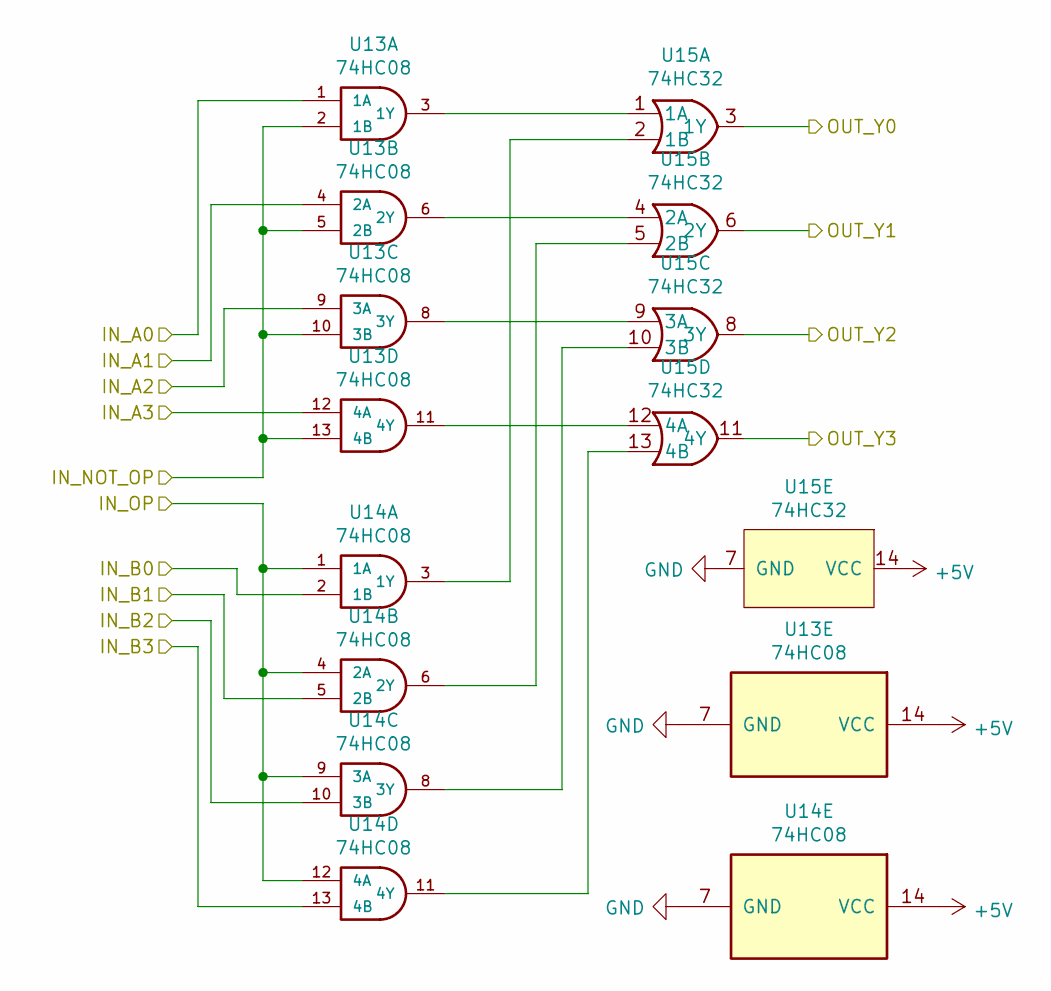
[picture p22: schematic op-mux.sch]

Parts:
U13, U14: 74HC08; SOIC-14_3.9x8.7mm_P1.27mm; LCSC C5593
U15: 74HC32; SOIC-14_3.9x8.7mm_P1.27mm; LCSC C5632

Connections:
+5V: U13.14 (VCC), U14.14 (VCC), U15.14 (VCC); also elsewhere on the board
/SheetALU/IN_OP1: U14.1 (1A), U14.4 (2A), U14.9 (3A), U14.12 (4A); also elsewhere on the board
/SheetALU/SheetOperationMux/IN_A0: U13.1 (1A); also elsewhere on the board
/SheetALU/SheetOperationMux/IN_A1: U13.4 (2A); also elsewhere on the board
/SheetALU/SheetOperationMux/IN_A2: U13.9 (3A); also elsewhere on the board
/SheetALU/SheetOperationMux/IN_A3: U13.12 (4A); also elsewhere on the board
/SheetALU/SheetOperationMux/IN_B0: U14.2 (1B); also elsewhere on the board
/SheetALU/SheetOperationMux/IN_B1: U14.5 (2B); also elsewhere on the board
/SheetALU/SheetOperationMux/IN_B2: U14.10 (3B); also elsewhere on the board
/SheetALU/SheetOperationMux/IN_B3: U14.13 (4B); also elsewhere on the board
/SheetALU/SheetOperationMux/IN_NOT_OP: U13.2 (1B), U13.5 (2B), U13.10 (3B), U13.13 (4B); also elsewhere on the board
/SheetOutput/IN_NF: U15.11 (4Y); also elsewhere on the board
/SheetOutput/IN_Y0: U15.3 (1Y); also elsewhere on the board
/SheetOutput/IN_Y1: U15.6 (2Y); also elsewhere on the board
/SheetOutput/IN_Y2: U15.8 (3Y); also elsewhere on the board
GND: U13.7 (GND), U14.7 (GND), U15.7 (GND); also elsewhere on the board
unnamed: U13.3 (1Y), U15.1 (1A)
unnamed: U13.6 (2Y), U15.4 (2A)
unnamed: U13.8 (3Y), U15.9 (3A)
unnamed: U13.11 (4Y), U15.12 (4A)
unnamed: U14.3 (1Y), U15.2 (1B)
unnamed: U14.6 (2Y), U15.5 (2B)
unnamed: U14.8 (3Y), U15.10 (3B)
unnamed: U14.11 (4Y), U15.13 (4B)

Parts of its further copies:
U10, U11: 74HC08; SOIC-14_3.9x8.7mm_P1.27mm; LCSC C5593
U12: 74HC32; SOIC-14_3.9x8.7mm_P1.27mm; LCSC C5632

Connections of its further copies:
+5V: U10.14 (VCC), U11.14 (VCC), U12.14 (VCC); also elsewhere on the board
/SheetALU/IN_OP0: U11.1 (1A), U11.4 (2A), U11.9 (3A), U11.12 (4A); also elsewhere on the board
/SheetALU/SheetLogic/IN_NOT_OR: U10.2 (1B), U10.5 (2B), U10.10 (3B), U10.13 (4B); also elsewhere on the board
/SheetALU/SheetLogic/sheet6027A5E8/IN_A0: U10.1 (1A); also elsewhere on the board
/SheetALU/SheetLogic/sheet6027A5E8/IN_A1: U10.4 (2A); also elsewhere on the board
/SheetALU/SheetLogic/sheet6027A5E8/IN_A2: U10.9 (3A); also elsewhere on the board
/SheetALU/SheetLogic/sheet6027A5E8/IN_A3: U10.12 (4A); also elsewhere on the board
/SheetALU/SheetLogic/sheet6027A5E8/IN_B0: U11.2 (1B); also elsewhere on the board
/SheetALU/SheetLogic/sheet6027A5E8/IN_B1: U11.5 (2B); also elsewhere on the board
/SheetALU/SheetLogic/sheet6027A5E8/IN_B2: U11.10 (3B); also elsewhere on the board
/SheetALU/SheetLogic/sheet6027A5E8/IN_B3: U11.13 (4B); also elsewhere on the board
/SheetALU/SheetOperationMux/IN_B0: U12.3 (1Y); also elsewhere on the board
/SheetALU/SheetOperationMux/IN_B1: U12.6 (2Y); also elsewhere on the board
/SheetALU/SheetOperationMux/IN_B2: U12.8 (3Y); also elsewhere on the board
/SheetALU/SheetOperationMux/IN_B3: U12.11 (4Y); also elsewhere on the board
GND: U10.7 (GND), U11.7 (GND), U12.7 (GND); also elsewhere on the board
unnamed: U10.3 (1Y), U12.1 (1A)
unnamed: U10.6 (2Y), U12.4 (2A)
unnamed: U10.8 (3Y), U12.9 (3A)
unnamed: U10.11 (4Y), U12.12 (4A)
unnamed: U11.3 (1Y), U12.2 (1B)
unnamed: U11.6 (2Y), U12.5 (2B)
unnamed: U11.8 (3Y), U12.10 (3B)
unnamed: U11.11 (4Y), U12.13 (4B)

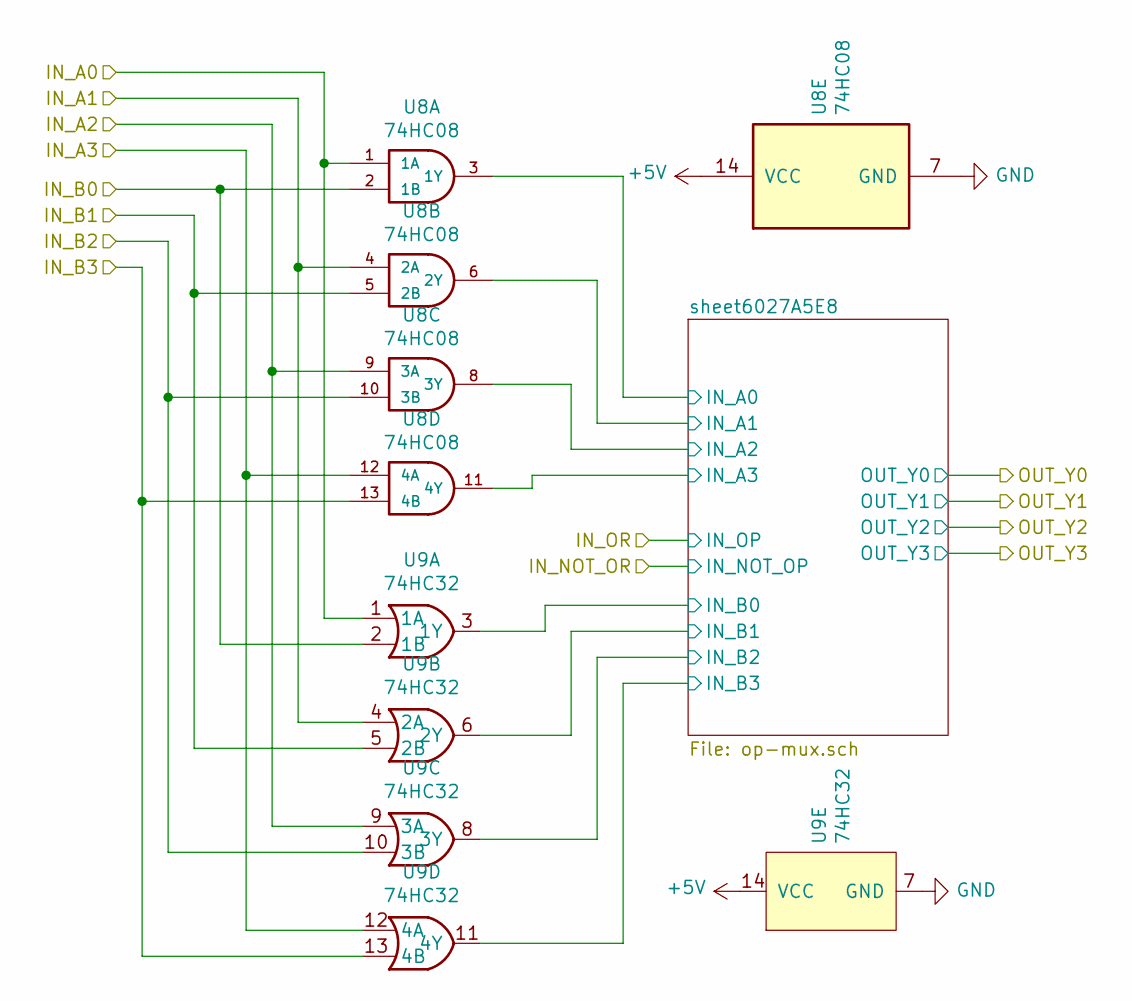
[picture p23: schematic logic.sch]

Parts:
U8: 74HC08; SOIC-14_3.9x8.7mm_P1.27mm; LCSC C5593
U9: 74HC32; SOIC-14_3.9x8.7mm_P1.27mm; LCSC C5632

Connections:
+5V: U8.14 (VCC), U9.14 (VCC); also elsewhere on the board
/SheetALU/IN_A0: U8.1 (1A), U9.1 (1A); also elsewhere on the board
/SheetALU/IN_A1: U8.4 (2A), U9.4 (2A); also elsewhere on the board
/SheetALU/IN_A2: U8.9 (3A), U9.9 (3A); also elsewhere on the board
/SheetALU/IN_A3: U8.12 (4A), U9.12 (4A); also elsewhere on the board
/SheetALU/IN_B0: U8.2 (1B), U9.2 (1B); also elsewhere on the board
/SheetALU/IN_B1: U8.5 (2B), U9.5 (2B); also elsewhere on the board
/SheetALU/IN_B2: U8.10 (3B), U9.10 (3B); also elsewhere on the board
/SheetALU/IN_B3: U8.13 (4B), U9.13 (4B); also elsewhere on the board
/SheetALU/SheetLogic/sheet6027A5E8/IN_A0: U8.3 (1Y); also elsewhere on the board
/SheetALU/SheetLogic/sheet6027A5E8/IN_A1: U8.6 (2Y); also elsewhere on the board
/SheetALU/SheetLogic/sheet6027A5E8/IN_A2: U8.8 (3Y); also elsewhere on the board
/SheetALU/SheetLogic/sheet6027A5E8/IN_A3: U8.11 (4Y); also elsewhere on the board
/SheetALU/SheetLogic/sheet6027A5E8/IN_B0: U9.3 (1Y); also elsewhere on the board
/SheetALU/SheetLogic/sheet6027A5E8/IN_B1: U9.6 (2Y); also elsewhere on the board
/SheetALU/SheetLogic/sheet6027A5E8/IN_B2: U9.8 (3Y); also elsewhere on the board
/SheetALU/SheetLogic/sheet6027A5E8/IN_B3: U9.11 (4Y); also elsewhere on the board
GND: U8.7 (GND), U9.7 (GND); also elsewhere on the board

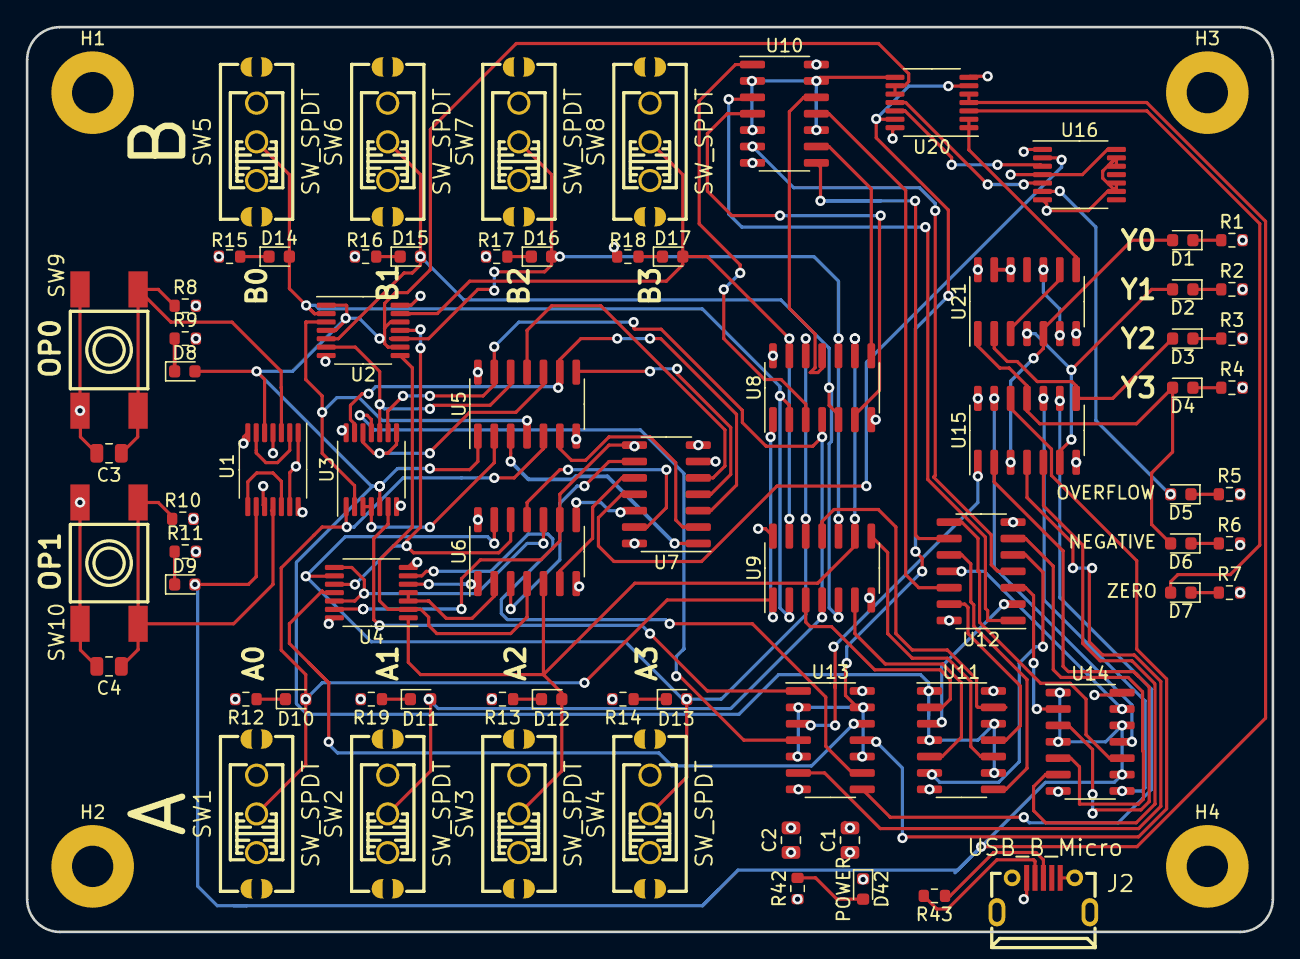
[picture p24: board PB170.kicad_pcb from above]

Board: 4 copper layers, 96.5 x 70.1 mm, 76 parts (0 on the bottom side), 101 nets.
