oklinov/alu/(commit log)

2020-12-08 Initial commit.
    [PB170.kicad_pcb, PB170.sch]
2020-12-09 Added PCB.
    [PB170.kicad_pcb, PB170.sch]
2020-12-09 Added hierarchical sheet example.
    [PB170.kicad_pcb, PB170.sch, xor.sch]
2020-12-10 Added 3D packages.
    [PB170.kicad_pcb]
2020-12-27 Experimentally added 74HC08 symbol.
    [PB170.kicad_pcb, PB170.sch, newParts.sch, xor.sch]
2020-12-27 Added 74HC4511D and HEF4518BT.
    [PB170.kicad_pcb, newParts.sch]
2021-01-15 Added sample OR gate 74HC32.
    [PB170.kicad_pcb, PB170.sch, newParts.sch]
2021-01-21 Setup xor component, create ALU and ADDER sheets
    [PB170.sch, adder.sch, alu.sch, newParts.sch, xor.sch]
2021-01-21 Create adder
    [adder.sch, alu.sch, newParts.sch]
2021-01-23 Create sheet for logic part
    [PB170.sch, adder.sch, alu.sch, logic.sch, newParts.sch, xor.sch]
2021-01-23 Create operation multiplexer
    [PB170.sch, adder.sch, alu.sch, logic.sch, newParts.sch, op-mux.sch, xor.sch]
2021-01-23 Create overlow label in adder
    [adder.sch, alu.sch]
2021-01-23 Add alu output flags
    [PB170.sch, alu.sch, newParts.sch]
2021-01-23 Create empty InputSheet and OutputSheet
    [PB170.sch, adder.sch, alu.sch, input.sch, logic.sch, newParts.sch, op-mux.sch, output.sch]
2021-01-27 ALU finished
    [PB170.sch, adder.sch, alu.sch, input.sch, logic.sch, newParts.sch, op-mux.sch, output.sch]
2021-02-02 Remove xor from the main sheet
    [PB170.sch, adder.sch, alu.sch, input.sch, logic.sch, newParts.sch, op-mux.sch, output.sch]
2021-02-05 Created examples with new THT parts.
    [PB170.kicad_pcb, PB170.sch, newParts.sch]
2021-02-05 added switching buttons
    [input.sch, logic.sch, newParts.sch, output.sch]
2021-02-07 Fixed 3D packages.
    [PB170.kicad_pcb]
2021-02-07 Added sample previews.
2021-02-07 Fixed ovelapping parts.
    [PB170.kicad_pcb]
2021-02-07 Moved KiCad content from PB170 to root folder.
    [PB170.kicad_pcb, PB170.sch, newParts.sch, xor.sch]
2021-02-09 Changes kicad did when launching after merge
    [PB170.sch, newParts.sch]
2021-02-09 Add missing wire in adder
    [adder.sch]
2021-02-09 Add input switches
    [input.sch, output.sch]
2021-02-09 Annotate components in input and output
    [input.sch, output.sch]
2021-02-09 Anotate alu
    [adder.sch, alu.sch, logic.sch, op-mux.sch]
2021-02-10 tiny fixes in annotation
    [PB170.sch, adder.sch, alu.sch, input.sch, logic.sch, newParts.sch, op-mux.sch, output.sch]
2021-02-10 exchanged a single AND
    [adder.sch, alu.sch]
2021-02-10 removed USB C connector
    [PB170.sch, alu.sch]
2021-02-11 minor fixes
    [PB170.sch, adder.sch, alu.sch, input.sch, logic.sch, op-mux.sch, output.sch]
2021-02-11 fixed some footprints
    [PB170.sch, adder.sch, alu.sch, logic.sch, op-mux.sch, output.sch]
2021-02-12 Change R, C and LED footprints
    [PB170.sch, input.sch, output.sch]
2021-02-14 Put components on board, set up 3d models of button and switch
    [PB170.kicad_pcb, Untitled 1.ods, newParts.sch]
2021-02-16 Finished routing
    [PB170.kicad_pcb, alu.sch]
2021-02-17 Added labels
    [PB170.kicad_pcb]
2021-02-18 Fill main sheet header
    [PB170.sch]
2021-02-18 Remove tmp file
    [Untitled 1.ods]
